KaiyuanGONG/AI-Car/基于人工智能的自动驾驶小车控制——技术报告.md

@[TOC](目录)
# 1.总体思路
## 终极目标
完成小车的控制系统的设计和制作，做到配合小车的算法，实现小车的自动驾驶。

包括：能实现在十字路口根据红绿灯的指示进行自主转弯、	遇到斑马线要减速慢行、	遇到行人要停车让行、	遇到限速牌要调整速度等等
（自动驾驶的验证参考视频以及计算机设计大赛的比赛规则（待上传））

但是因为时间有限，这里只介绍==根据车道线自主移动==这一部分，即小车可以自处在如图所示的场地从起点开始进行自主移动，最后在终点停车。
##  细化目标
要完成自动驾驶小车的控制，最终实现自主移动，需要对要实现的功能进行细化。
#### 人工智能的开发流程
要细化整个过程需要对人工智能的整体开发流程有一个大概的了解，尤其是对于机器学习类的开发流程。（这个部分可以参考计算机设计大赛提供的参考资料（待上传）或者基本操作的《一个人工智能的诞生》（md到时候贴个链接））

总而言之，整个过程分成以下几个部分：

 - ==数据集==，数据集顾名思义就是数据的集合，数据是整个人工智能应用开发的基础，在自动驾驶小车中，数据集包括采集到的车道线、斑马线、限速牌、行人等等。但对小车的车道线检测来说来说，需要车载的处理器连接摄像头进行图像采集。
 *例如，在直行时，小车采集到的图像是两根完整的车道线且分别位于小车视角的左右两侧，但是当需要转弯，即车道线出现弯曲的时候两根车道线会位于小车视角的同一侧或者消失，这时候小车就需要转弯。*
 - ==模型训练==，采集到的数据集将用于人工智能模型训练，这部分是算法同学负责，你只需要知道他在模型训练之后所达到的效果：向模型输入图像，模型会根据图像做出识别，并根据图像输出对应的符号。
 - ==自主移动==，处理器发出符号之后，主控对符号进行接收和分析，并控制小车进行移动（在简单的车道线检测中，只有前几左转右转停车等）。
 
#### 自主移动系统的目标
 根据人工智能在车道线检测自主移动中的流程，小车应该实现两个目标对应两个过程：
 
 - ==图像采集==：小车具有前进后退转弯等基本能力，同时可以控制小车按照带有车道线的路线图进行运动，同时以某个固定频率进行实时的图像采集，并采集到的图像存储在处理器中，并将所采集好的图像按顺序打包发给负责算法的同学。
 - ==自主移动==：小车的主控板在接收到处理器发出的字符之后，必须嫩根据字符进对应移动，比如接收到F小车前进，接收到L小车左转等等。

#### 自主移动系统的设计
在明确目标之后，我们的设计就围绕自主移动系统的目标展开：
（设计总体参考老师提供的计算机设计大赛官方车（硬件资料待上传），省去过多的思考和不必要的麻烦，但同时这样的解决方案明不是最优解）
 - ==系统形态==：小车的动力来源是四个电机带动四个轮子靠摩擦力前进（左前方的轮子定义为0号，顺时针标号依次为1、2、3号），可以通过控制每个轮子的转速和方向来实现小车的直行和转弯。电机固定在一个底盘平台上，除此之外可以在平台上放置处理器、摄像头、电池等等。
 - ==运动模式==：运动模式由四个电机的差速控制。
	在直行时，四个电机都以相同的速度正转。
	转弯时，以左转为例，有两种方式：
	第一种，0、3号轮子反转，1、2号轮子正转，小车会原地转向。
	第二种，0号轮子反转，1、2、3号轮子轮子正转，小车会边前进边转向。
	两种转向的方法其实都一样，改变电机转向的代码也比较容易改。转标准的90度弯用第二种更方便，但是改变角度时会影响速度，时机不好把握；第二种方法把角度和速度完全分开，方便小车根据实时图像进行自动调整。
 - ==电机控制算法==：要完成小车自主移动控制系统，很重要的一点就是小车的运动状态，而小车的运动状态又完全是由四个电机的转动速度和方向决定的，所以对每个电机的转速的控制就非常重要。要做到控制转速能根据目标值快速变化，快速趋于稳定，且能在一定范围内保持稳定
 - ==图像采集过程==：图像采集需要摄像头安装在小车合适的位置，并由处理器控制进行图像采集。在进行图像采集的过程中，小车需要进行远程操控的移动，所以除小车之外需要自己制作一个遥控器用来操控小车进行移动。
 - ==自主移动过程==：小车与处理器之间相互发送信息，需要通过串口通信。

# 2.知识准备
## Arduino
#### Arduino IDE
Arduino中国官网上面有很多大佬写的帖子可以参考一下，我这里分享一个Arduino快速入门全集。
（链接待补充）
#### 一些硬件的基本知识
一般情况下，小车和手柄中电路用模块比较多，知道电压电流的特点、红线接正极黑线接负极这些最基本的电路只是就够用了。
如果想继续精进，比如自己设计电路板等就需要知道整流、放大等常见电路组合的使用和搭建方法。
#### Arduino 与 硬件结合
可以自己购买或者使用实验室的套件，按照我如下的建议路线进行学习：
使用Arduino UNO 点亮板载LED小灯、向串口发送Hello world！、通过串口发送字符来控制小灯的亮灭、点亮外接LED小灯、点亮外接多色小灯、用开关控制小灯、用滑动变阻器控制小灯、用电位器控制小灯、控制一位数码管、控制多位数码管或者点阵、控制LCD屏幕、控制蜂鸣器、控制超声波模块、控制直流电机、控制直流减速电机、配合驱动模块控制直流减速电机。
## Python
学习Python的基本语法。熟悉常见的概念、能看懂基本的代码。控制方面用到的比较少，仅用于借助Python让处理器和主控板之间完成串口通信。
## 其他
#### Github的使用
Github应该都知道就不赘述了，不会用Git托管代码可以多用用GIthub，自己开几个库把代码按照版本放在里面是非常重要的。同时GIthub上面也有非常多大佬的代码，可以扒下来多参考和借鉴，现在好多大公司比如微软都把自己的更新材料放在上面，许多大厂在面试的时候也会问你Github项目，你甚至可以把自己的大作业保存到上面防止丢失，所以作为一个写代码的，有Github账号并熟练使用其功能是非常必要的。（Github首页就有自己的QuickStart，入门非常快）
#### Markdown的使用
Markdown是一种代码式的文本编辑语言，借助这种方式，写文档就和写代码感觉一样，所以这种文本编辑器非常受程序员喜欢，也因此在很多网络资源中，经常会有一个叫readme.md的文件，md这个后缀就说明文件使用Markdown写的，同时也需要用对应的方式打开。我个人非常喜欢用这种语言，以前总是桌面新建一个ｔｘｔ文件来记东西，现在就方便很多了。
至于Markdown的编辑器，我使用的是Ｔｙｐｏｒａ，非常好用，可以在官网直接下载，暂时免费，我这里写了一篇参考文件，可以在下载后打开学习（待上传）
#### SolidWorks的使用
SolidWorks是一个三维建模软件，我在制作小车模型的时候用到了这个非常重要的软件，主要用于对小车的每个零件进行建模为外观设计和加工做准备，小车上的每一个模块每一个零件都进行了详细的建模，这样做出来的小车才会这样严丝合缝。
SolidWorks网上的资源很多，完全可以自己寻找，学习资源建议使用SolidWorks自带的学习资源（位置帮助－基础教程－基础技术），把自带的学习资源学习完你就是高手了，之后就是多动手多画零件，在实践中学习进步会非常快。
## 其他资料
其他资料可以见我的Github库。
# 3.物资准备
主要是写一下做这辆车完整需要用到哪些东西（因为软件也不是很懂，所以主要是写硬件的东西）。绝大部分物资的参数都可以从购买渠道了解到，方便了解到第一手的信息和重新选择购买复现小车。
#### 做硬件的一些设备
就一些基本的，电烙铁得有得会用吧，包括一些配套的烙铁架、焊锡、吸锡器、[导线](https://detail.tmall.com/item.htm?id=41296905861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)、热缩管、热风枪等等。还需要有万用表、示波器等电路功能检测的工具。还有很多肯定会用到的东西我就不多说了，比如剪刀、[镊子](https://detail.tmall.com/item.htm?id=536088476057&spm=a1z09.2.0.0.4d4d2e8dkUuLs9&_u=j35362bc9e25)、热熔胶、３M胶等等。最后就是各种[螺丝](https://item.taobao.com/item.htm?spm=a1z09.2.0.0.4d4d2e8dkUuLs9&id=586305415774&_u=j35362bc02e9)[铜柱](https://detail.tmall.com/item.htm?id=542688036669&spm=a1z09.2.0.0.4d4d2e8dkUuLs9&_u=j35362bc90b2)，建议多用内六角的，然后各种长度都买一些。（做完一个毕设感觉自己宿舍就跟一个小仓库一样）
#### 物品清单及购买渠道汇总
1. 实验室获取：
主控板Arduino Uno以及与其相配套的Aruino豪华配件。（这个不重要，按照我上面写的豪华路线来学习就好了）
2. 淘宝购入
主控板[Arduino Nano](https://item.taobao.com/item.htm?spm=a1z09.2.0.0.4d4d2e8dkUuLs9&id=529472942000&_u=j35362bc22e5)、[Arduino Mega2560](https://item.taobao.com/item.htm?spm=a1z09.2.0.0.4d4d2e8dkUuLs9&id=601910639382&_u=j35362bcc0b4)、Arduino Uno
升压模块、[电源稳压模块](https://detail.tmall.com/item.htm?id=571929153142&spm=a1z09.2.0.0.4d4d2e8dkUuLs9&_u=j35362bc3ea7)、[杜邦线](https://detail.tmall.com/item.htm?id=521388098764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)等等
[１２V定制电池组](https://detail.tmall.com/item.htm?id=520111996213&spm=a1z09.2.0.0.4d4d2e8dkUuLs9&_u=j35362bcaa4b)及其充电器等配件
[３.７V锂电池及其配套电池底座](https://item.taobao.com/item.htm?spm=a1z09.2.0.0.4d4d2e8dkUuLs9&id=15916831250&_u=j35362bcf8fb)等等
[L298N电机驱动模块](https://item.taobao.com/item.htm?spm=a1z09.2.0.0.4d4d2e8dkUuLs9&id=571082650753&_u=j35362bc6a96)
电机及其配套[６５ｍｍ](https://item.taobao.com/item.htm?spm=a1z09.2.0.0.4d4d2e8dkUuLs9&id=584588142034&_u=j35362bca02b)、[８５ｍｍ](https://item.taobao.com/item.htm?spm=a1z09.2.0.0.4d4d2e8dkUuLs9&id=564022532292&_u=j35362bc5fbf)两种轮子、[联轴器JY61](https://detail.tmall.com/item.htm?id=635856208589&spm=a1z09.2.0.0.4d4d2e8dkUuLs9&_u=j35362bc8266)等等
陀螺仪
[碳纤维贴纸](https://detail.tmall.com/item.htm?id=602426608747&spm=a1z09.2.0.0.4d4d2e8dkUuLs9&_u=j35362bc8e05)、[亚克力胶水](https://detail.tmall.com/item.htm?id=593358040993&spm=a1z09.2.0.0.4d4d2e8dkUuLs9&_u=j35362bcab2b)等
3. 闲鱼购入
Jetson Nano裸机、[亚克力外壳](https://detail.tmall.com/item.htm?id=627952530147&spm=a1z09.2.0.0.4d4d2e8dkUuLs9&_u=j35362bc3783)、[无线网卡](https://detail.tmall.com/item.htm?id=634140774131&spm=a1z09.2.0.0.4d4d2e8dkUuLs9&_u=j35362bc0ef7)、[摄像头](https://detail.tmall.com/item.htm?id=636111925349&spm=a1z09.2.0.0.4d4d2e8dkUuLs9&_u=j35362bcd319)等等

#### 学会买东西和加工东西
在整个小车的制作和调试过程中肯定有很多东西是需要购买或者自己加工的，
比如要购买的：电池、各种电源模块、甚至电线，这些东西在买的时候不要贪便宜，一定买值得信赖的店里的。
比如要加工的：亚克力板、打印件。这些东西一般是自己给出图纸，由商家报价，这类东西由于是需要定制的，所以一般价格波动非常大。打印件可以先搜索“速加网”进入官方，然后将零件的图纸上传自动报价，然后把这个价格减去百分之５到百分之１５去淘宝询价。对于亚克力板，直接加这个微信(wxid_8ww2bm30esdu22)加工就完事了，除非你能找到更便宜的或者自己加工，这个是我找了很多加工商之后的优质商家。

# 4.硬件设计
硬件设计分遥控器和小车本体两个部分来说：（因为实物就在手里，所以我就只文字描述，具体图标可以看我论文）（介绍的是小车当前情况的硬件设计，关于改进在最后一部分会说）

（1）遥控器
  - 遥控器的硬件结构比较简单，接线略复杂，但是我会提供手柄模块的电路图（待上传）遥控器一节3.7V的锂电池 经过3.7V转9V的升压模块给 Arduino Nano供电，Arduino Nano直接连接Arduino手柄模块（手柄模块包含遥感和按钮）、蓝牙模块直接连在手柄模块上。

（2）小车本体
 - 小车本体的结构也比较简单，用两节3.7V的电池串联额外给主控板供电。一套电压为12V的锂电池组经过稳压模块给电机驱动模块供电，驱动模块再连接电机的电机电源线和编码器电源线，电机的A B相线连接在主控板上用来接收编码器的脉冲信号来测定电机转动的速度，同时主控给蓝牙模块供电。

# 5.软件设计
这部分采用介绍代码功能加贴代码的形式来描述，代码注释不多，自己理解一下，自认为命名还都挺明白，全部代码可以在我稍后会长传到我的Github上面，可以下载。

（1）遥控器
主要是使用遥控模块的功能，包含一个摇杆和四个按钮，这里只用了摇杆的功能。
摇杆控制逻辑示意图
```c
// Github文件名为Control.ino
/*
板子开关打到3.3V  341/343 365/368 值的范围是0到720  
手柄中间位置的模拟值490/491  523/524，（板子电源选择开关打到5V，值的范围0到1023）
设置一个前进后退转弯的功能
蓝牙模块通信
*/

#include<SoftwareSerial.h>
SoftwareSerial BlueTooth(8, 9); // RX,TX

int Up = 6;    // 上按钮不可用，其他三个正常
int Right = 3; // 按下右边按钮时digitalRead(Right)的值为0，平常默认值为1
int Down = 4;
int Left = 5;
int X, Y = 0;
int style = 0;

void Init()
{
    pinMode(Up, INPUT_PULLUP);
    pinMode(Right, INPUT_PULLUP);
    pinMode(Down, INPUT_PULLUP);
    pinMode(Left, INPUT_PULLUP);
}

// 1，2，3. 4 分别代表前进，右转，后退，左转
void Style()
{

    if (X >= 200 && X <= 500 && Y >= 200 && Y <= 500)
    {
        style = 0;
    }

    if (Y > 500 && X > 200 && X < 500)
    {
        style = 1;
    }

    if (Y > 200 && Y < 500 && X > 500)
    {
        style = 2;
    }

    if (Y < 200 && X > 200 && X < 500)
    {
        style = 3;
    }

    if (Y > 200 && Y < 500 && X < 200)
    {
        style = 4;
    }
}

void setup(void)
{
    Init();
    Serial.begin(9600);
    BlueTooth.begin(9600);
    // Serial.println("init serial port AT");
}

void loop(void)
{
    Style();
    X = analogRead(A0);
    Y = analogRead(A1);

//if(BlueTooth.available()>0) {
    if (digitalRead(Right) == 0){
            BlueTooth.print("U");
        }
    if (digitalRead(Left) == 0){
            BlueTooth.print("C");
    }

    if (style == 0)
    {
        BlueTooth.print("S");
    }
    if (style == 1)
    {
        BlueTooth.print("F");
    }
    if (style == 2)
    {
        BlueTooth.print("R");
    }
    if (style == 3)
    {
        BlueTooth.print("B");
    }
    if (style == 4)
    {
        BlueTooth.print("L");
    }
    delay(1);
}
```

（2）小车本体

小车本体所包含的功能比较多，所以先把几个功能的逻辑讲清楚，然后再贴对应代码。
 - ==小车电机驱动程序设计==
小车使用的是L298N电机驱动模块去驱动六线AB相的直流减速电机。
所以设置一个四行五列的二维数组Motor_Pins来代表四个电机的所有端口，每一行的四个端口分别是IN1、IN2、PWM、EncodeA、EncodeB（即中端A和中断B），（但在实际变成过程中由于Mega2560外部中断接口个数受限，只使用了每个电机的中断A。
当需要驱动电机的时候，先进行端口初始化，IN1、IN2、PWM设置为OUTPUT且默认状态为LOW，中断设置为INPUT。PWM的范围是0-255，通过控制输入PWM值的大小可以决定电机得转速（经过测试，空载速度在0-50，对应的PWM值是40-255）。IN1、IN2根据L298N的真值表，可以决定电机是正转、反转、还是不转。
参考的真值表
 - ==蓝牙模块程序设计==
这个部分主要设计到小车所使用的CH05模块的初始化，参数配置和调试，到时候会贴一个大佬的链接（待上传）
- ==计算电机转速==
因为使用的是带编码器的电机，所以可以通过使用主控的外部中断读取到电机的脉冲频率，再结合电机的加速比等信息可以计算出电机的转速。
Arduino外部中断的使用，使用函数attachInterrupt(interrupt, function, RISING)，上升沿检测信号脉冲，function设置MotorCount变量计数在50ms内的脉冲的个数。
最后速度v = ((MotorCount / (11 * 56)) * 6.5 * PI) / 0.05 其中11表示，电机每转过一圈有11个脉冲，电机减速比是56，轮子的直径是6.5cm，0.05表示在50ms以内。
 - ==PID控制算法==
PID是Proportional(比例)、Integral(积分)、Differential(微分)三者的缩写。PID调节是连续控制系统中技术最成熟、应用最广泛的调节方式。PID调节实质是根据输入的偏差值，按照比例、积分、微分的函数关系进行运算，运算结果用以控制输出。PID有增量式PID和位置式PID两种，由于我们使用的是增量式霍尔编码器所以我们着重研究增量式PID。使用前面提到的增量PID的公式第二条：离散式PID计算公式
在进行代码实现的时候，PWMInc表示PWM的增量，Ek表示目标值与当前值的差，Ek1、Ek2保存上一步的Ek值，Kp、Ki、Kd分别是比例、积分、微分三个系数，计算表达式为PWMInc＝Kp*Ek-Ki*Ｅk1+Kd*EK2。
再加上利用millis()函数的每5ms一次的时间中断。　
然后再每次主程序循环开始之前通过PWM = PWM + PWMInc来不断更新，以改变不同电机的转速。
PID参数的调整，PID三个参数的调整对电机的控制效果有很大的影响且三个参数会相互影响,根据前面章节提到的调参公式和模拟效果，确定最终参数位Kp=5，Ki=0.3.Kd=0.5

```c
// Github文件名为final.ino
/***********************************
电机序号编号
0号电机（LF左前）   1号电机（RF右前）
2号电机（RB右后）   3号电机（LB左后）
*************************************/
/*****************************************
更新日志2021年5月24日，毕业答辩前一天重构代码
******************************************/

// 包含头文件 软串口、定时中断
#include <SoftwareSerial.h>
#include <FlexiTimer2.h>

// 蓝牙接口定义
SoftwareSerial BlueTooth(50, 51); // RX,TX

// 电机端口初始化极其含义
//IN1 IN2 PWM EncodeA EncodeB
int MotorPins[4][5] = {
    {6, 17, 7, 2, 28},
    {12, 15, 4, 21, 30},
    {11, 16, 5, 20, 26},
    {23, 8, 13, 3, 24},
};

// 一些全局变量的定义
// 数圈数 当前速度 目标速度 目标角度 PWM 等
int MotorCount = 0; //反正每次只能测一个电机的转速，所以不是数组
float Velocity[4] = {0};
float Target[4] = {0};
float Target_V = 0; //输入专用速度
String TargetVelocity;
float TargetA = 0;
String TargetAngle;
float PWMControl[4] = {0};
int PWMStart[4] = {0, 0, 0, 0};
int PWM[4] = {0}; //PWM是整数

// PID 参数定义及设置   四个轮子使用四套PID参数
typedef struct
{
    float Kp; //比例系数Proportional
    float Ki; //积分系数Integral
    float Kd; //微分系数Derivative

    float Ek;  //当前误差
    float Ek1; //前一次误差 e(k-1)
    float Ek2; //再前一次误差 e(k-2)
} PID_IncTypeDef;

PID_IncTypeDef pid0 = {10, 1, 0.1, 0, 0, 0};
PID_IncTypeDef pid1 = {10, 1, 0.1, 0, 0, 0};
PID_IncTypeDef pid2 = {10, 1, 0.1, 0, 0, 0};
PID_IncTypeDef pid3 = {10, 1, 0.1, 0, 0, 0};
PID_IncTypeDef pid[4] = {pid0, pid1, pid2, pid3};

// 程序初始化
void setup()
{
    MotorInit();                   //电机初始化
    Serial.begin(9600);            //硬串口初始化
    BlueTooth.begin(9600);         //蓝牙使用的软串口初始化
    FlexiTimer2::set(5, control);  //时间中断初始化
    FlexiTimer2::start();          //每5ms中断一次，中断函数为control
}

// 程序进入主循环
void loop()
{
    // 计算当前实际速度
    GetV();
    // 蓝牙读取遥控器指令及对应操作判断
    char ch = BlueTooth.read(); // 传递信息
    switch (ch)
    {
    case 'S':
        Stop();
        break;

    case 'F':
        GoForward(1);
        break;

    case 'B':
        GoBackward(1);
        break;
    case 'L':

        TurnLeft(60);
        break;
    case 'R':

        TurnRight(60);
        break;
        
// 对电机的各个参数进行初始化
void MotorInit()
{
    for (int i = 0; i < 4; i++)
    {
        pinMode(MotorPins[i][0], OUTPUT);
        pinMode(MotorPins[i][1], OUTPUT);
        pinMode(MotorPins[i][2], OUTPUT);
        pinMode(MotorPins[i][3], INPUT);
        pinMode(MotorPins[i][4], INPUT);

        digitalWrite(MotorPins[i][0], LOW);
        digitalWrite(MotorPins[i][1], LOW);
        digitalWrite(MotorPins[i][2], LOW);
    }
}

// 定时中断的函数
void control()
{
    //计算对应当前目标速度的PWM增量值
    for (int n = 0; n < 4; n++)
    {
        PWMControl[n] = PwmInc(n, Target[n]);
    }
    // 对PWMControl的值进行处理并得到PWM
    SetPWM();
    // 不断更新角度数据
}

//计算当前某序号电机的实际速度
void GetV()
{
    // n是电机的序号,更新并保存四个电机的转速
    for (int n = 0; n < 4; n++)
    {
        MotorCount = 0;
        unsigned long nowtime = 0;
        nowtime = millis() + 50;
        attachInterrupt(digitalPinToInterrupt(MotorPins[n][3]), ReadMotor, RISING); // 2560 的中断2口对应编号0
        while (millis() < nowtime)
            ;
        detachInterrupt(digitalPinToInterrupt(MotorPins[n][3]));
        // 轮组直径8.5cm 电机A相每圈11个脉冲 电机减速比为56：1 计算转速时间间隔为50ms
        Velocity[n] = MotorCount * 8.5 * PI / 11 / 56 / 0.05;
    }
}
void ReadMotor()
{
    MotorCount++;
}

// 不同的运动模式
void DriveMotor(int n, int TargetV)
{
    Target[n] = TargetV;
    if(Target[n] == 0) {
        digitalWrite(MotorPins[n][0], LOW);
        digitalWrite(MotorPins[n][1], LOW);
    }
    if(Target[n] > 0) {
        digitalWrite(MotorPins[n][0], LOW);
        digitalWrite(MotorPins[n][1], HIGH);
    }
    if(Target[n] < 0) {
        digitalWrite(MotorPins[n][0], HIGH);
        digitalWrite(MotorPins[n][1], LOW);
    }
    analogWrite(MotorPins[n][2], PWMStart[n]+PWM[n]);
}

void Stop()
{
    // 为了保证响应速度，每个电机会设置一个刚好不使轮子转动的PWM值
    Target[0] = 0;
    Target[1] = 0;
    Target[2] = 0;
    Target[3] = 0;
}
void GoForward(int TargetV)
{
    Target[0] = TargetV;
    Target[1] = TargetV;
    Target[2] = TargetV;
    Target[3] = TargetV;
}
void GoBackward(int TargetV)
{
    Target[0] = -TargetV;
    Target[1] = -TargetV;
    Target[2] = -TargetV;
    Target[3] = -TargetV;
}
void TurnLeft(int TargetV)
{
    Target[0] = -TargetV;
    Target[1] = TargetV;
    Target[2] = TargetV;
    Target[3] = TargetV;
}
void TurnRight(int TargetV)
{
    Target[0] = TargetV;
    Target[1] = -TargetV;
    Target[2] = TargetV;
    Target[3] = TargetV;
}

//输出电机的转速、PWM值、角度
void PrintV()
{
    Serial.println("******输出电机转速******");
    for (int i = 0; i < 4; i++)
    {
        Serial.print("Motor");
        Serial.print(i);
        Serial.print(":");
        Serial.print(Velocity[i]);
        Serial.print("  ");
    }
    Serial.println();
}
void PrintPwm()
{
    Serial.println("******输出电机PWM值******");
    for (int i = 0; i < 4; i++)
    {
        Serial.print("PWM");
        Serial.print(i);
        Serial.print(":");
        Serial.print(PWM[i]);
        Serial.print("  ");
    }
    Serial.println();
}
void PrintAngle()
{
}

// 将计算好的PWMControl进行限制并赋值到PWM[4]
void SetPWM()
{
    for (int n = 0; n < 4; n++)
    {
        if (PWMControl[n] > 255)
        {
            PWM[n] = 255;
        }
        PWM[n] = (int)PWMControl;
    }
    DriveMotor(0, Target[0]);
    DriveMotor(1, Target[1]);
    DriveMotor(2, Target[2]);
    DriveMotor(3, Target[3]);
}

// 通过增量PID计算PWM增量
float PwmInc(int n, float SetValue)
{
    if(SetValue < 0) {
        SetValue = -SetValue;
    }
    float PWMInc = 0;
    float ActualValue = 0;

    PID_IncTypeDef *PID = &pid[n];

    ActualValue = Velocity[n];

    PID->Ek = SetValue - ActualValue;
    PWMInc += (PID->Kp * PID->Ek) - (PID->Ki * PID->Ek1) + (PID->Kd * PID->Ek2);

    PID->Ek2 = PID->Ek1;
    PID->Ek1 = PID->Ek;

    return PWMInc;
}

```

# 6.测试及问题
## 已解决的问题
#### PID使用的问题
#### 遥控器与小车通信的问题

## 仍存在的问题
#### 结构方面
- 四个轮子中心所构成的不是一个正方形，这个问题还是比较致命的，会导致小车在转弯的时候动力不够。之前设计的时候是由考虑好的，但是由于换了85mm轮子没有考虑轮子宽度，所以调换了安装方向。
- 开关位置不合适，开关就是塞到底盘板里面的，但是由于尺寸设计问题，开关会必预设的低很多，有时候会导致非常尴尬的意外关机的情况，这个问题很好解决，把开关塞进去就行了。
- 供电问题，理想状态下应该是小车的电池给处理器供电，处理器的USB接口再给主控板供电，但是现在主控板外接两3.7V电池串联供电，处理器用充电宝供电，然后用远程桌面控制。之后应该改成同一由12V电池给所有用电设备供电（包括更多的用电设备例如显示屏和摄像头等），这也是一开始就选择定制大容量锂电池的初心。
- 外壳设计方面，本来在设计之初，应该是每个板的厚度都是5mm然后都用3mm的螺丝固定，但是再加工的时候脑抽了，觉得3mm便宜所以部分选了3mm的，最后导致没有找到合适的螺母最终无法完成装配，最后用亚克力胶粘的，这个真的是设计的一大败笔，后边要继续用的话肯定得改进重做。
#### 功能方面
- 陀螺仪没加，开始的时候看了官方小车的操作流程。感觉需要角度角度和速度的实时反馈，但是实际队友在操作的时候明显使用了一种非常简单的方式，所以就只加了陀螺仪，但是代码没有加进去。
- 角度PID，加入陀螺仪之后，角度控制也需要配置PID，这样才能实现角度的控制。
- 遥控器，之前我在使用遥控器的时候是没有问题的，但是在遥控器放了很久，新车刚装好的时候，遥控器出了问题，我认为是遥控器的手柄模块摇杆部分出现了问题或者是蓝牙部分的供电电路存在问题，导致小车在用遥控器控制的时候。

# 7.总结与展望
从一开始选了郑老师这个题目撰写任务书、开题报告，再到最后毕业答辩结束。在做毕设中遇到了很多困难，也一一化解，并从中学到了很多。

现在回想起来，其实导致很多困难以及最终结果不遂人愿的原因是很大一个原因是：只知道最终目标和完成的效果，但是对细节目标及其不明确，不知道是在做什么、不知道方案执行中的细节，说人话就是从一开始到最后写完论文都是在瞎做。

但是现在回过头来写技术报告，是非常清晰和明了，这也就是我问什么在这篇技术报告的第一章就写细化目标的原因，这部分才本次毕业设计工程问题真正的精髓，如果这部分很清楚，后边的技术部分也是如鱼得水顺理成章。

这大概也就是做工程设计解决工程问题的魅力吧，只有一个前进的方向和目标，但是道路黑灯瞎火甚至还崎岖不平，最终克服重重困难到达胜利的彼岸。
