KaiyuanGONG/AI-Car/官方资料/地图/地图测试.pptx

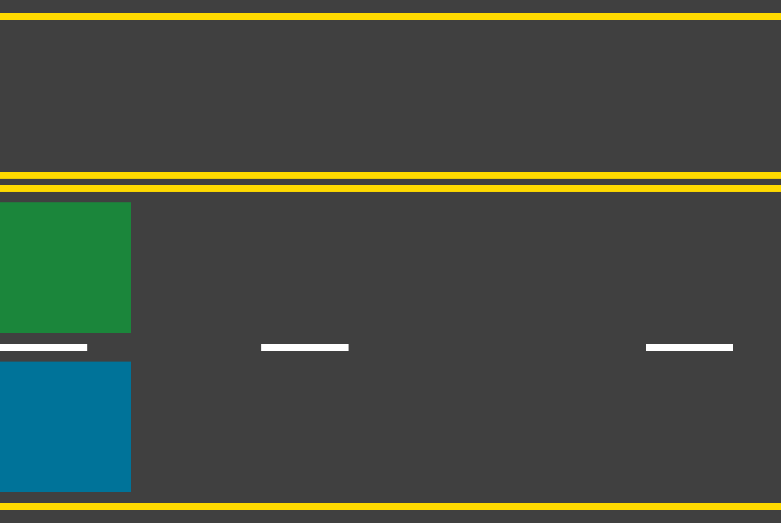
[picture p17: figure]
左侧直车道
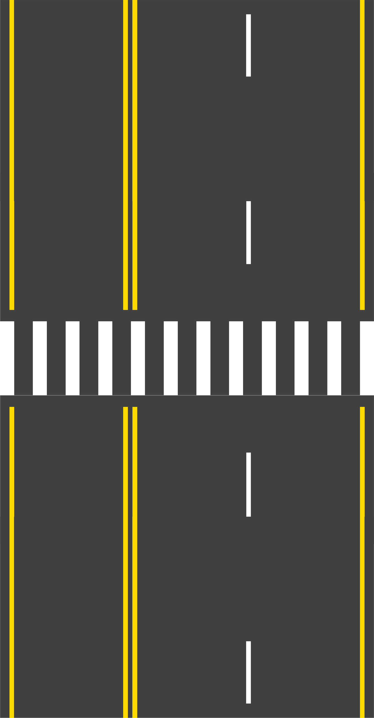
[picture p18: figure]
最终斑马线
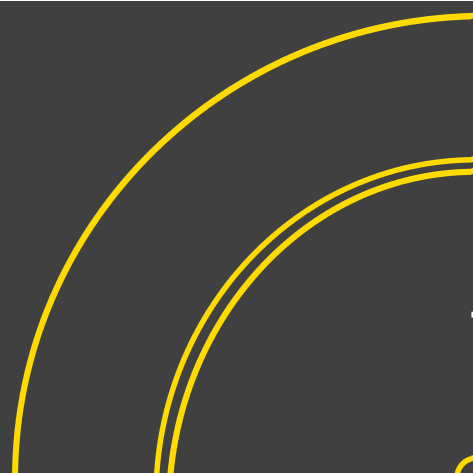
[picture p19: figure]
07 右转弯
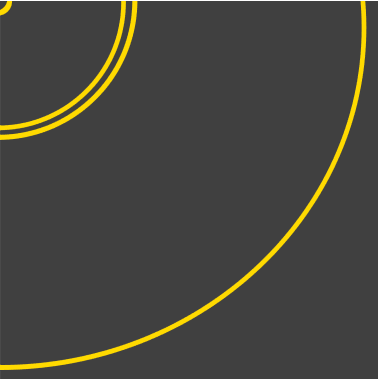
[picture p20: figure]
03 左转弯
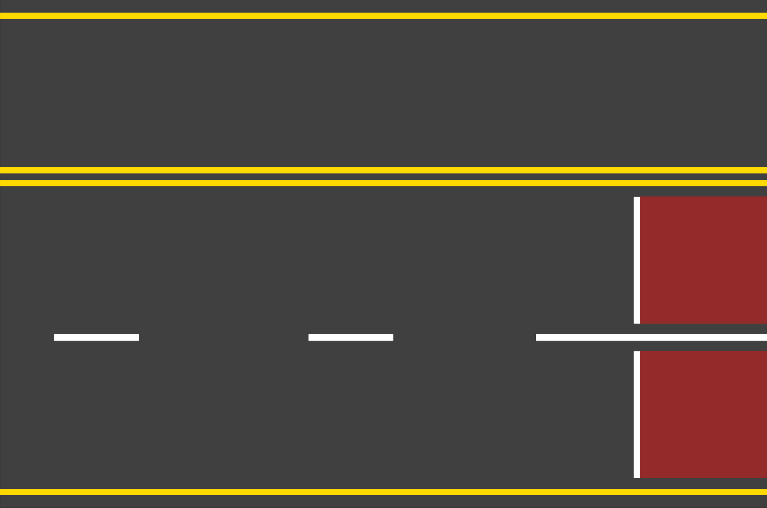
[picture p21: figure]
右侧直车道
