KaiyuanGONG/AI-Car/其他资料/JoyShield资料/PINOUT==0G-00004701==JoystickShield.jpg

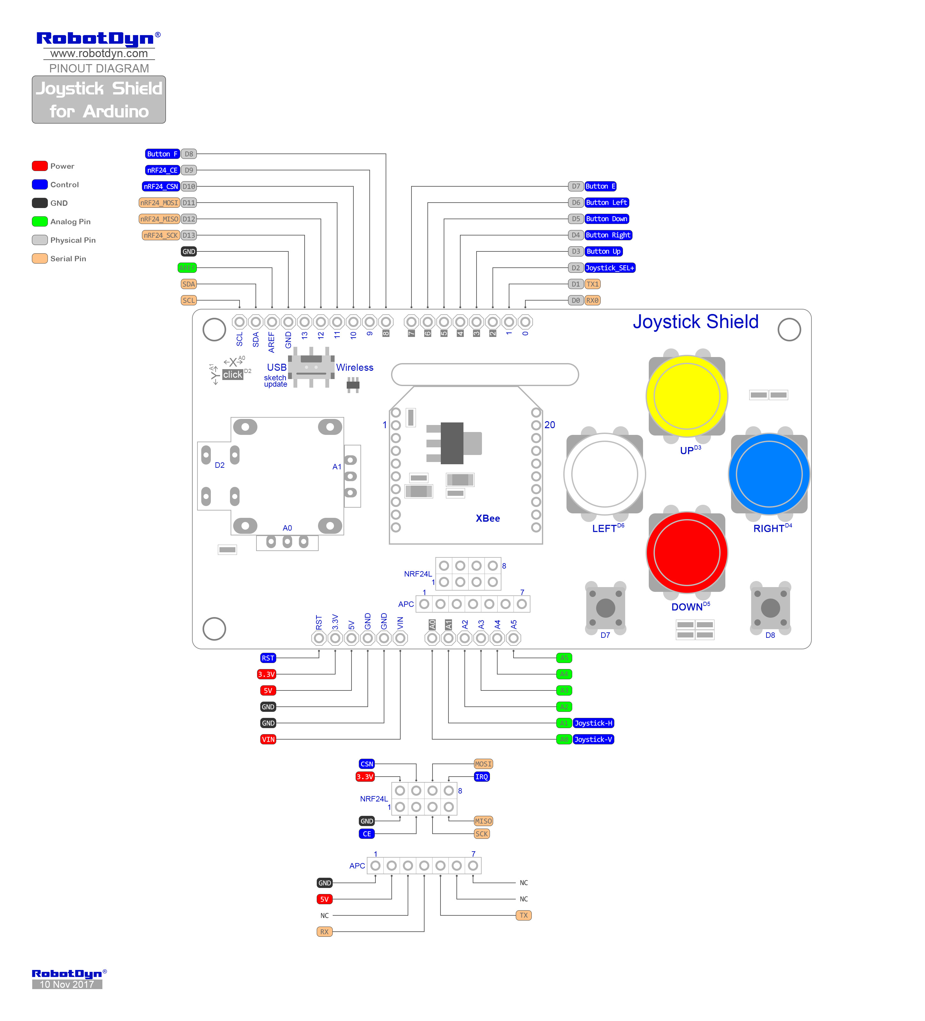
其他资料/JoyShield资料/PINOUT==0G-00004701==JoystickShield.jpg
