KaiyuanGONG/AI-Car/官方资料/地图/R01.png

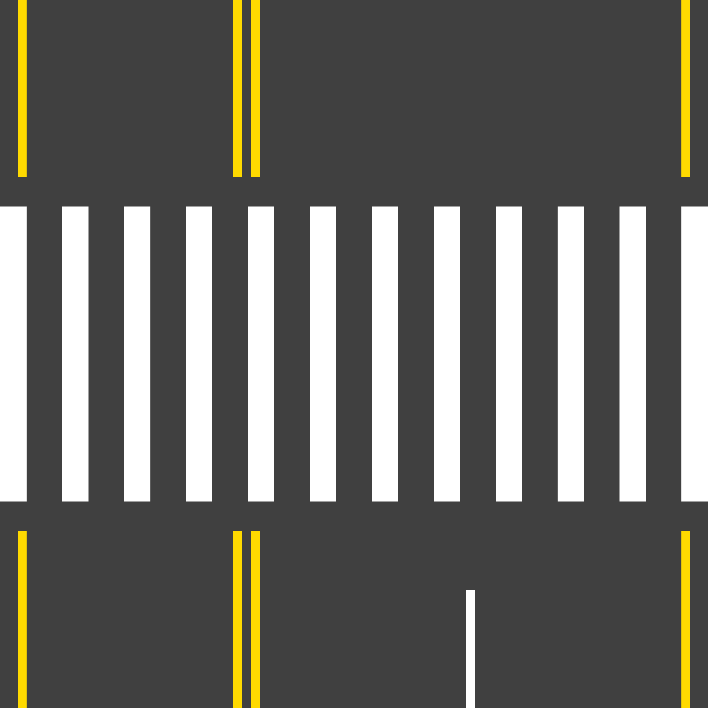
官方资料/地图/R01.png
