KaiyuanGONG/AI-Car/手柄模型/手柄装配体/手柄装配体.SLDASM

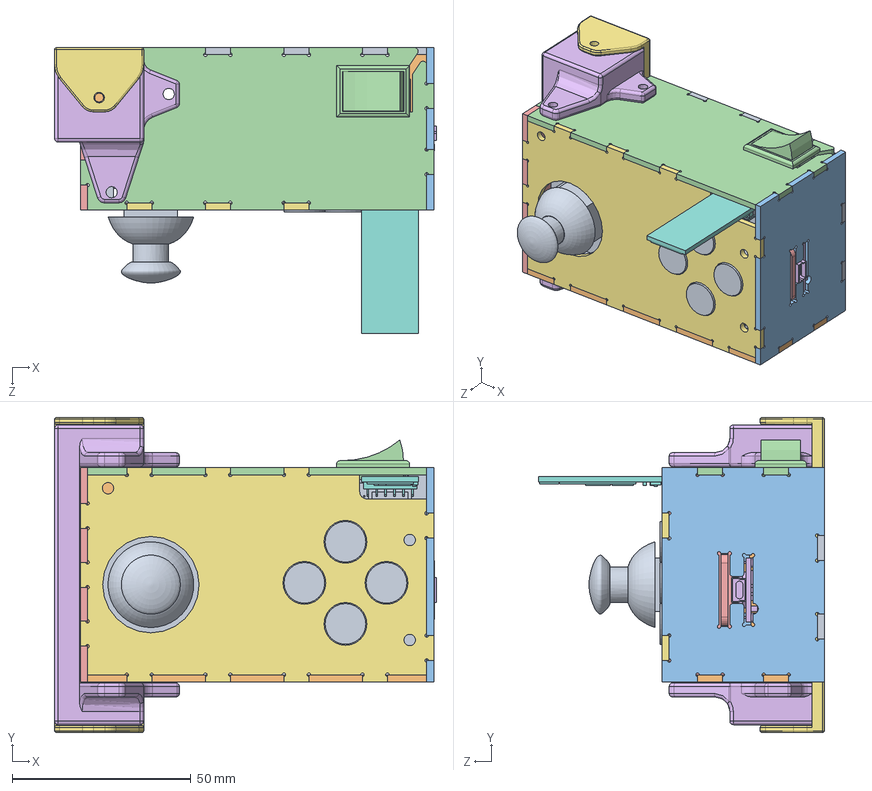
[picture p30: CAD file, 2021-06-19]
手柄模型/手柄装配体/手柄装配体.SLDASM
107.0 x 88.3 x 80.1 mm
JoyShield
BaseBattery
3.7V9
SwitchTwoFt
Board_Nano
Nano
Board_Joy
HC05BlousTooth
Board_Bottom
Board_Side2
Board_Side1
Board_Side0
Board_Side3
Protect_Bat
Board_Bat
