KaiyuanGONG/AI-Car/机械图纸/装配体/车壳（除底盘）.SLDASM

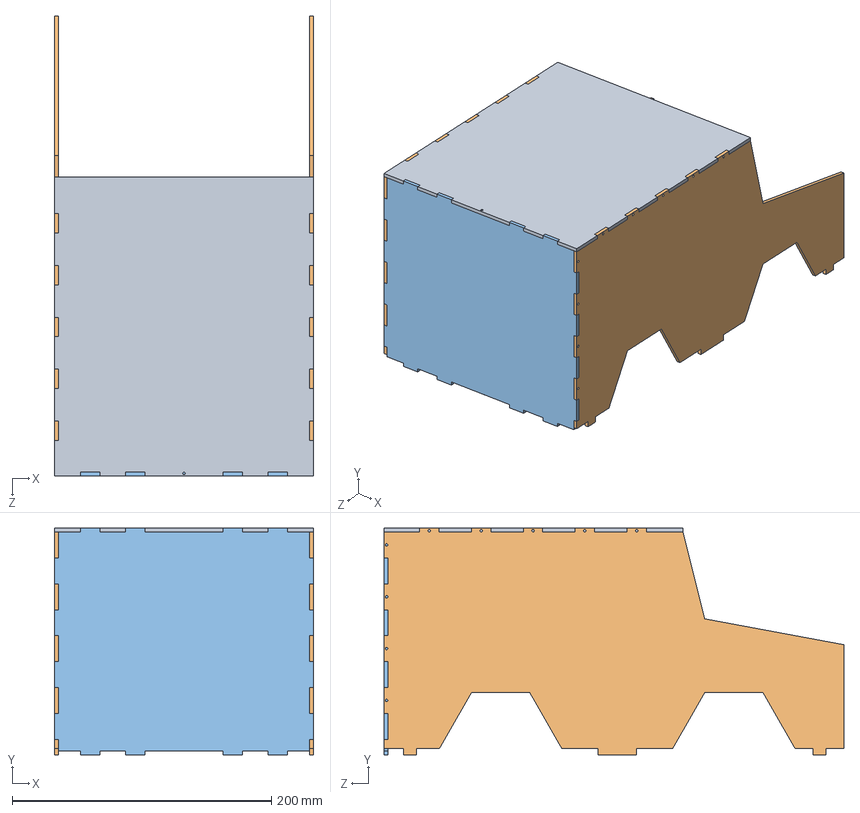
[picture p31: CAD file, 2021-06-19]
机械图纸/装配体/车壳（除底盘）.SLDASM
200.0 x 175.0 x 355.0 mm
车顶板
车侧板 x 2
车后板
