KaiyuanGONG/AI-Car/机械图纸/轮组/低轮组.SLDASM

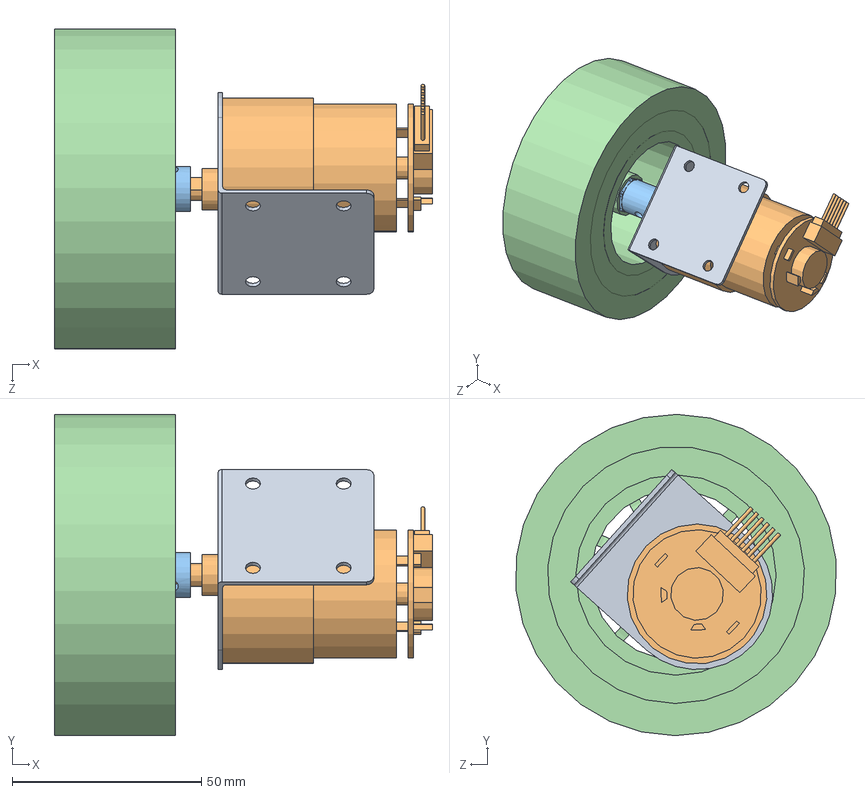
[picture p32: CAD file, 2021-06-19]
机械图纸/轮组/低轮组.SLDASM
100.0 x 85.0 x 84.6 mm
BaseMotor
Motor
Coupling
Tyre
