KaiyuanGONG/AI-Car/机械图纸/装配体/计算核心.SLDASM

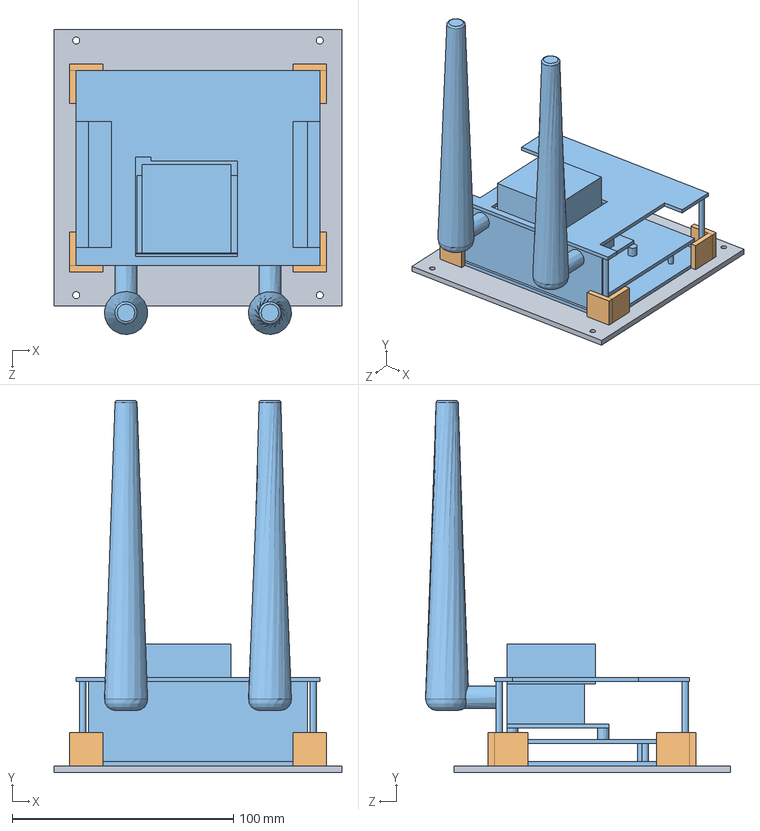
[picture p33: CAD file, 2021-06-19]
机械图纸/装配体/计算核心.SLDASM
130.0 x 168.0 x 137.8 mm
Nano固定
电池挡板 x 8
JatsonNano
