KaiyuanGONG/AI-Car/机械图纸/装配体/电源供电.SLDASM

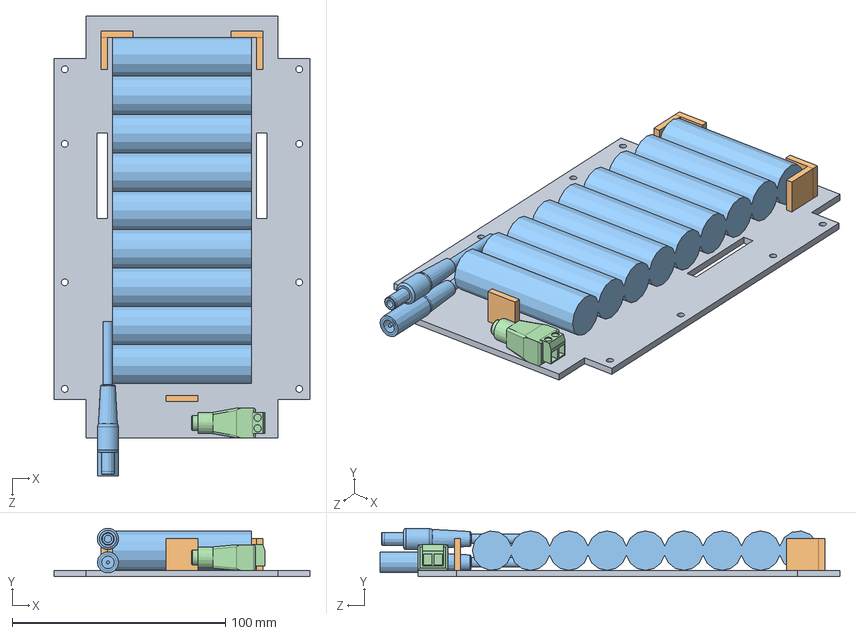
[picture p34: CAD file, 2021-06-19]
机械图纸/装配体/电源供电.SLDASM
120.0 x 22.8 x 215.9 mm
电池固定板
电池挡板 x 5
Battery
ConnectorFemale
