KaiyuanGONG/AI-Car/机械图纸/装配体/整车外壳.SLDASM

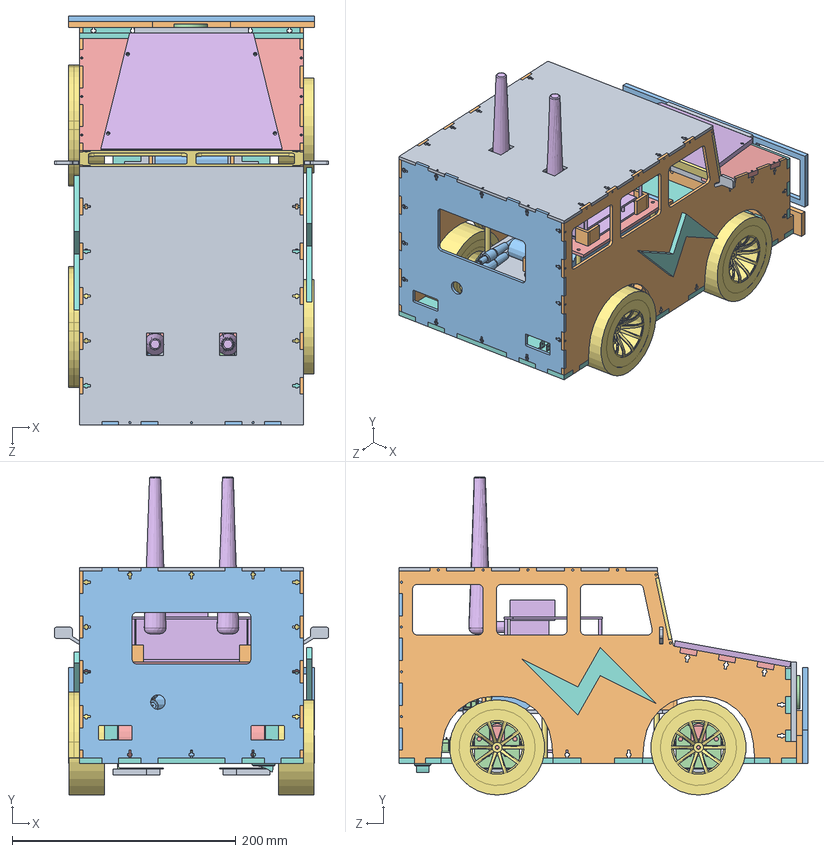
[picture p35: CAD file, 2021-06-19]
机械图纸/装配体/整车外壳.SLDASM
244.9 x 284.0 x 365.0 mm
车顶板
车侧板 x 2
车后板
BaseMotor x 4
Motor x 4
Coupling x 4
Tyre x 4
底盘
轮组固定板 x 4
L298N x 2
JY61
VoltageRegulatorSourse
分电板
40mm支撑铜柱 x 8
SwitchTwoFt
电池固定板
电池挡板 x 13
Battery
ConnectorFemale
Nano固定
JatsonNano
前挡风玻璃
车大灯 x 2
车前网
前保险杠
车前架
奔驰标志
引擎盖翼 x 2
引擎盖中
轮胎装饰 x 4
侧边装饰 x 2
后视镜 x 2
