KaiyuanGONG/AI-Car/机械图纸/装配体/底盘装配体.SLDASM

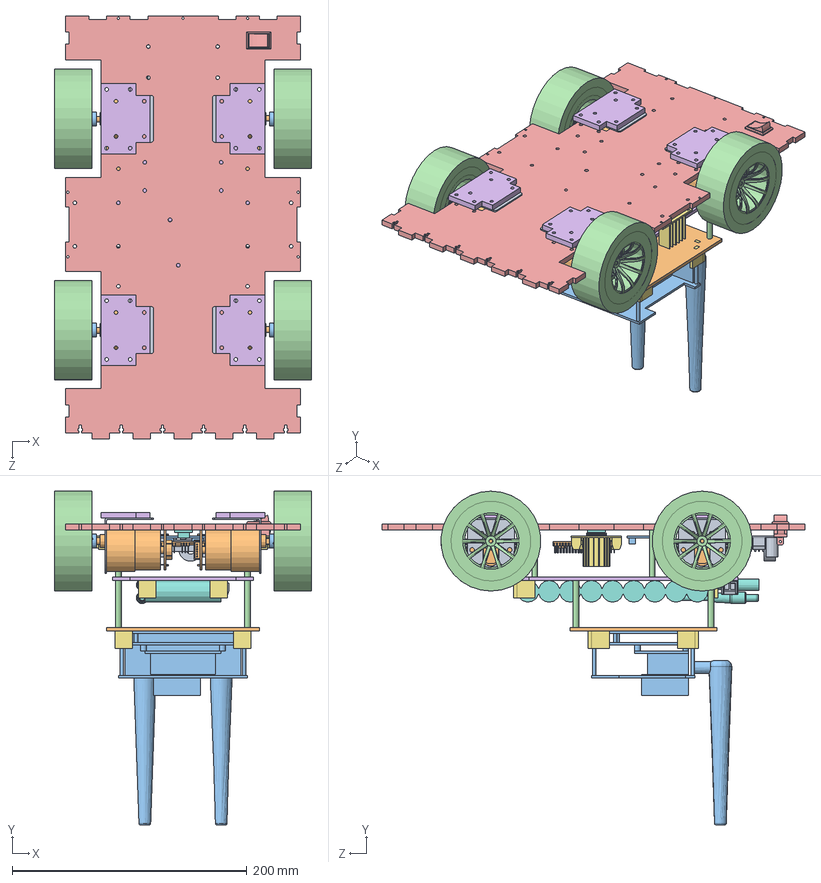
[picture p36: CAD file, 2021-06-19]
机械图纸/装配体/底盘装配体.SLDASM
219.0 x 284.0 x 360.0 mm
BaseMotor x 4
Motor x 4
Coupling x 4
Tyre x 4
底盘
轮组固定板 x 4
L298N x 2
JY61
VoltageRegulatorSourse
分电板
40mm支撑铜柱 x 8
SwitchTwoFt
电池固定板
电池挡板 x 13
Battery
ConnectorFemale
Nano固定
JatsonNano
