KaiyuanGONG/AI-Car/手柄模型/手柄机械零件/Board_Side1.SLDPRT

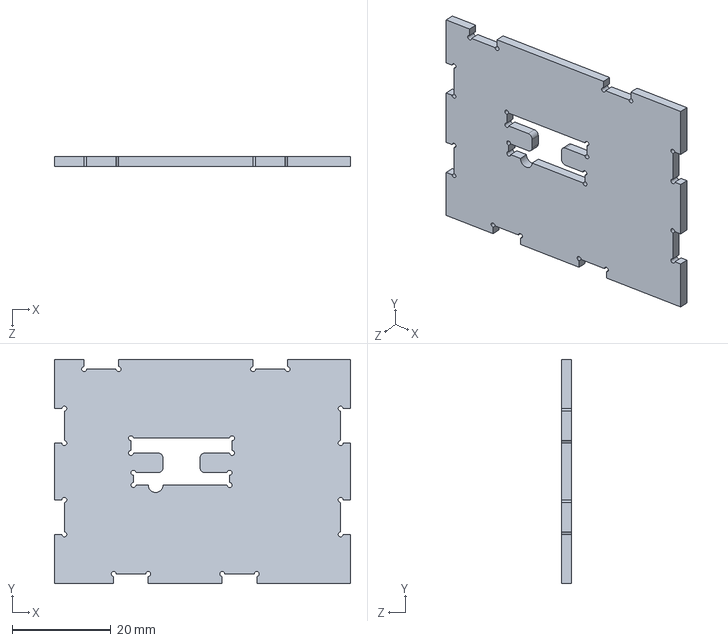
[picture p37: CAD file, 2021-06-19]
手柄模型/手柄机械零件/Board_Side1.SLDPRT
60.0 x 45.5 x 2.00 mm
