KaiyuanGONG/AI-Car/手柄模型/手柄电气零件/JoyShield.SLDPRT

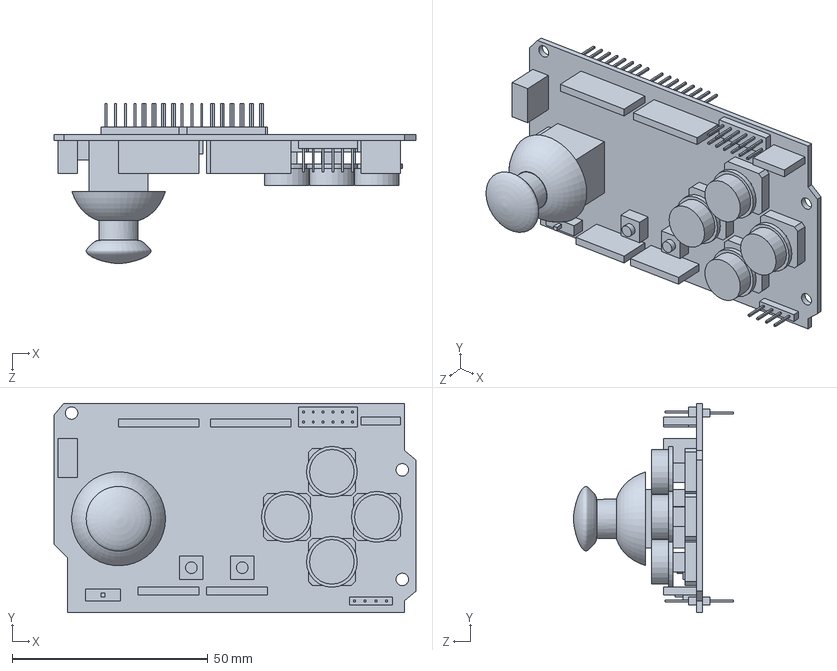
[picture p38: CAD file, 2021-06-19]
手柄模型/手柄电气零件/JoyShield.SLDPRT
92.5 x 53.5 x 41.0 mm
