KaiyuanGONG/AI-Car/机械图纸/外壳零件/车大灯.SLDPRT

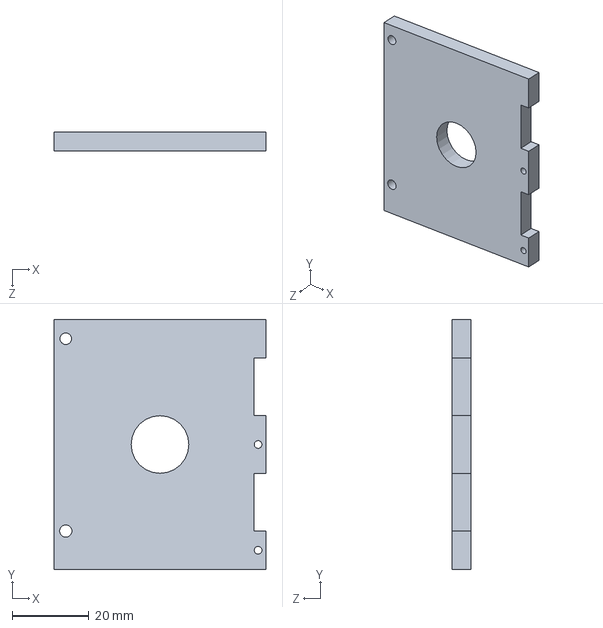
[picture p39: CAD file, 2021-06-19]
机械图纸/外壳零件/车大灯.SLDPRT
55.0 x 65.0 x 5.00 mm
