KaiyuanGONG/AI-Car/机械图纸/底盘（待使用）.SLDPRT

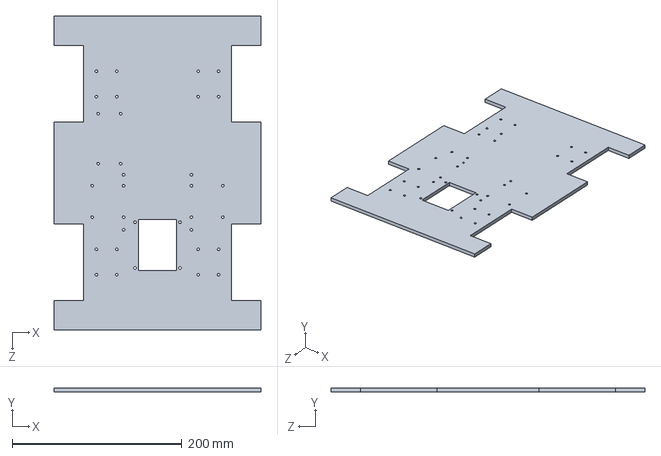
[picture p40: CAD file, 2021-06-19]
机械图纸/底盘（待使用）.SLDPRT
244.0 x 5.00 x 370.0 mm
