KaiyuanGONG/AI-Car/机械图纸/电气零件/JY61.SLDPRT

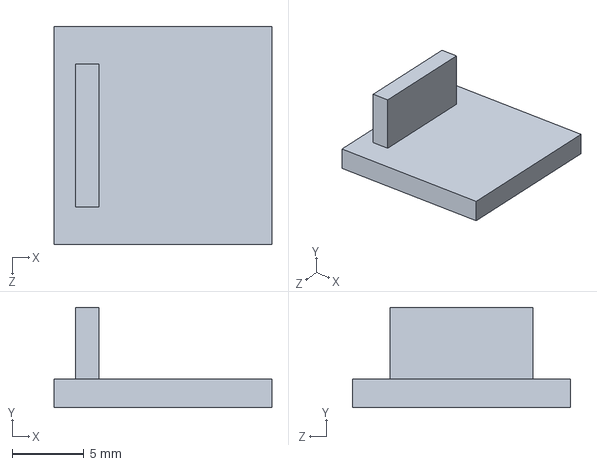
[picture p41: CAD file, 2021-06-19]
机械图纸/电气零件/JY61.SLDPRT
15.2 x 7.00 x 15.2 mm
