KaiyuanGONG/AI-Car/手柄模型/手柄机械零件/Board_Bottom.SLDPRT

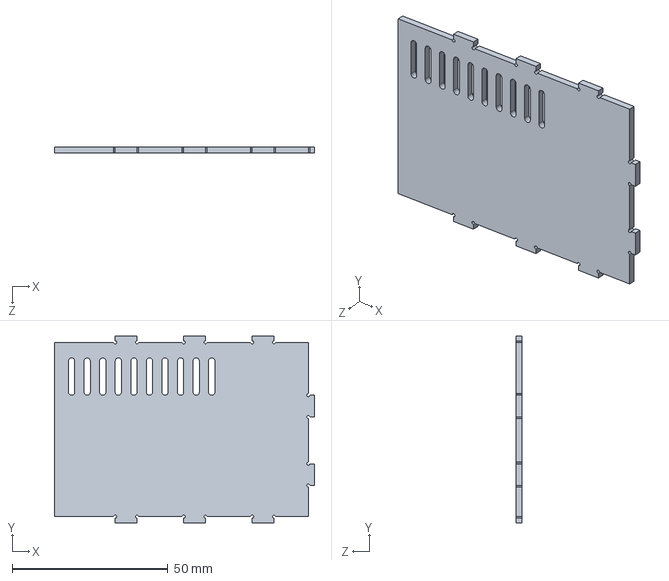
[picture p42: CAD file, 2021-06-19]
手柄模型/手柄机械零件/Board_Bottom.SLDPRT
83.5 x 60.0 x 2.00 mm
