KaiyuanGONG/AI-Car/手柄模型/手柄电气零件/BaseBattery.SLDPRT

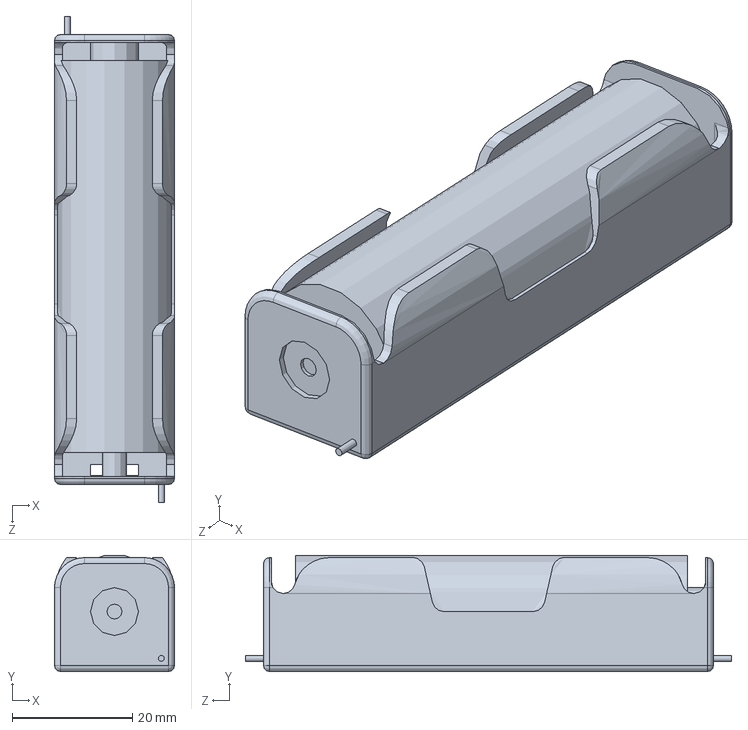
[picture p43: CAD file, 2021-06-19]
手柄模型/手柄电气零件/BaseBattery.SLDPRT
20.0 x 19.4 x 81.0 mm
