KaiyuanGONG/AI-Car/机械图纸/外壳零件/轮胎装饰.SLDPRT

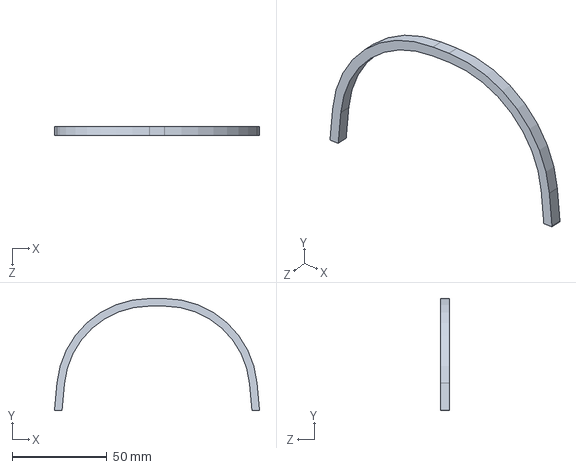
[picture p44: CAD file, 2021-06-19]
机械图纸/外壳零件/轮胎装饰.SLDPRT
108.0 x 59.0 x 5.00 mm
