KaiyuanGONG/AI-Car/机械图纸/电气零件/ConnectorFemale.SLDPRT

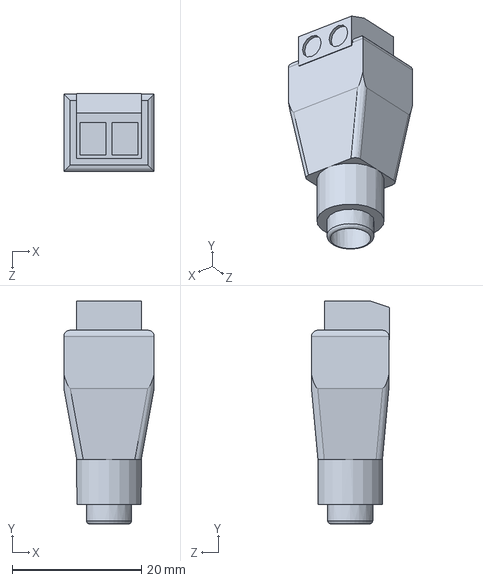
[picture p45: CAD file, 2021-06-19]
机械图纸/电气零件/ConnectorFemale.SLDPRT
14.0 x 34.5 x 12.1 mm
