KaiyuanGONG/AI-Car/机械图纸/轮组/Motor.SLDPRT

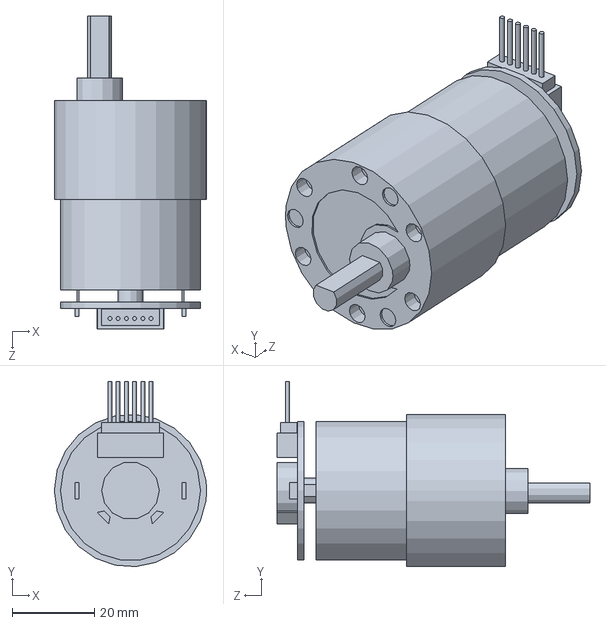
[picture p46: CAD file, 2021-06-19]
机械图纸/轮组/Motor.SLDPRT
37.0 x 45.0 x 76.0 mm
