KaiyuanGONG/AI-Car/手柄模型/手柄机械零件/Board_Side3.SLDPRT

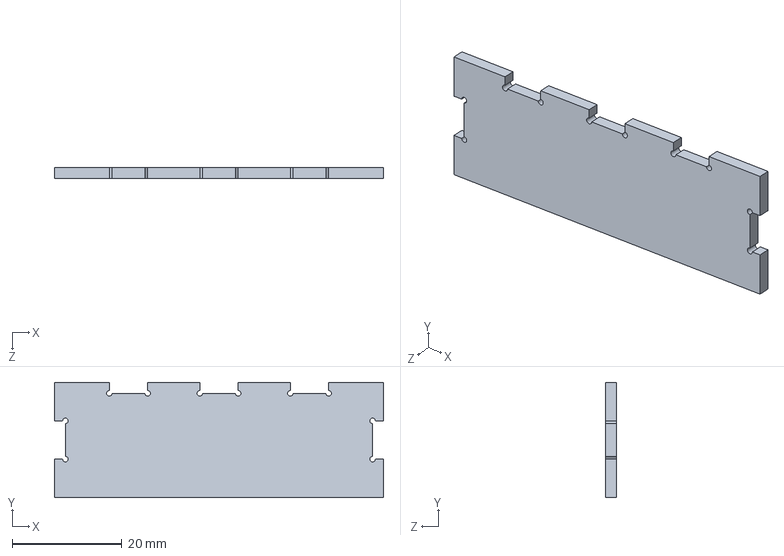
[picture p47: CAD file, 2021-06-19]
手柄模型/手柄机械零件/Board_Side3.SLDPRT
60.0 x 21.0 x 2.00 mm
