KaiyuanGONG/AI-Car/手柄模型/手柄电气零件/3.7V9.SLDPRT

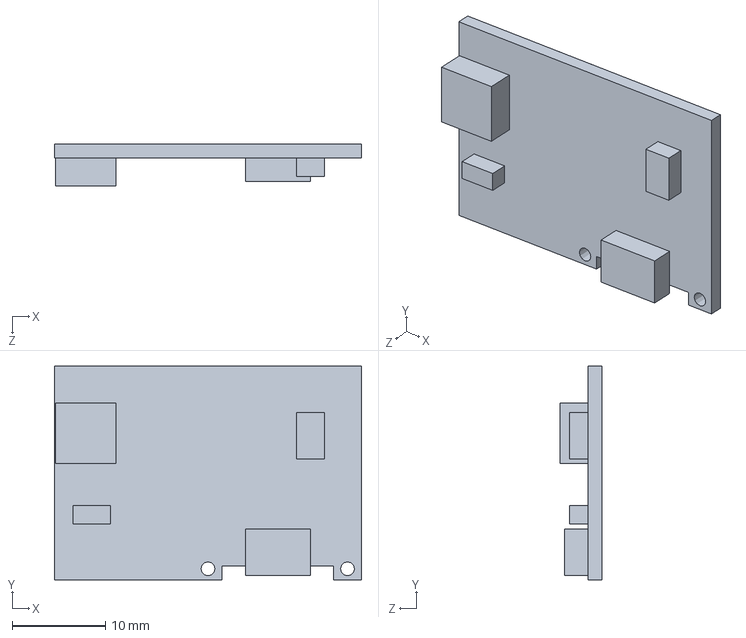
[picture p48: CAD file, 2021-06-19]
手柄模型/手柄电气零件/3.7V9.SLDPRT
33.0 x 23.0 x 4.50 mm
