KaiyuanGONG/AI-Car/机械图纸/外壳零件/底盘.SLDPRT

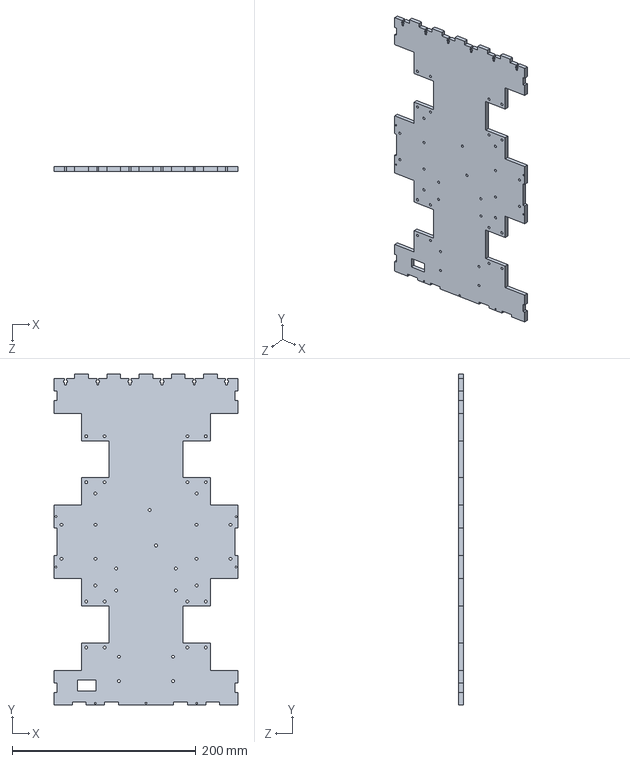
[picture p49: CAD file, 2021-06-19]
机械图纸/外壳零件/底盘.SLDPRT
200.0 x 360.0 x 5.00 mm
