KaiyuanGONG/AI-Car/机械图纸/电气零件/L298N.SLDPRT

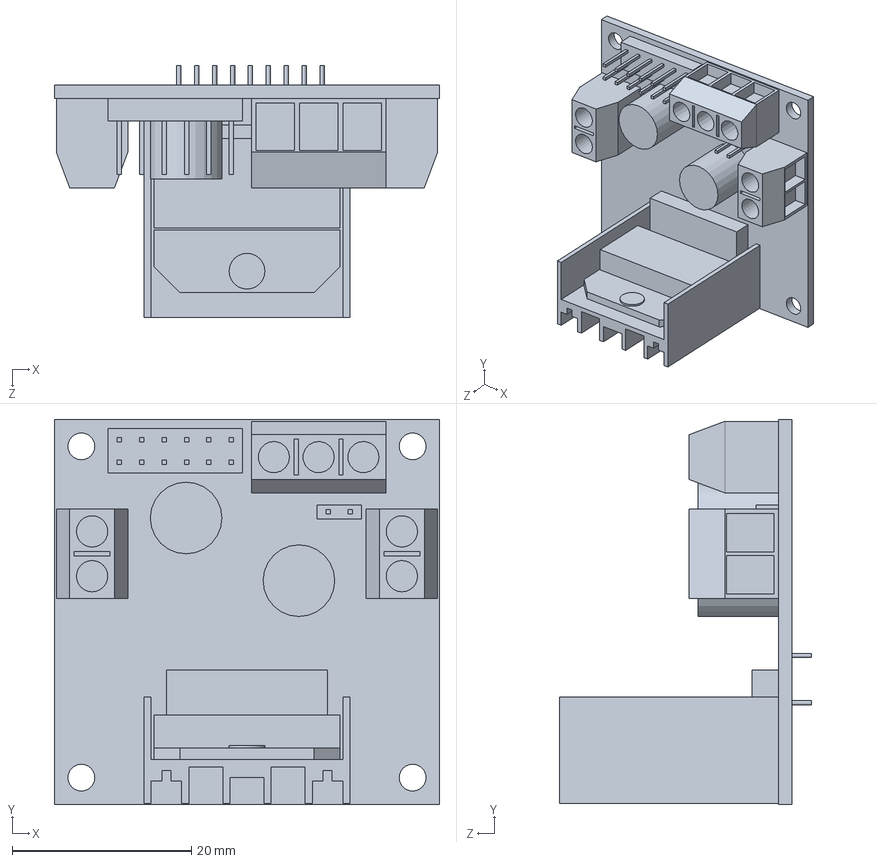
[picture p50: CAD file, 2021-06-19]
机械图纸/电气零件/L298N.SLDPRT
43.0 x 43.0 x 28.2 mm
