KaiyuanGONG/AI-Car/手柄模型/手柄机械零件/Board_Bat.SLDPRT

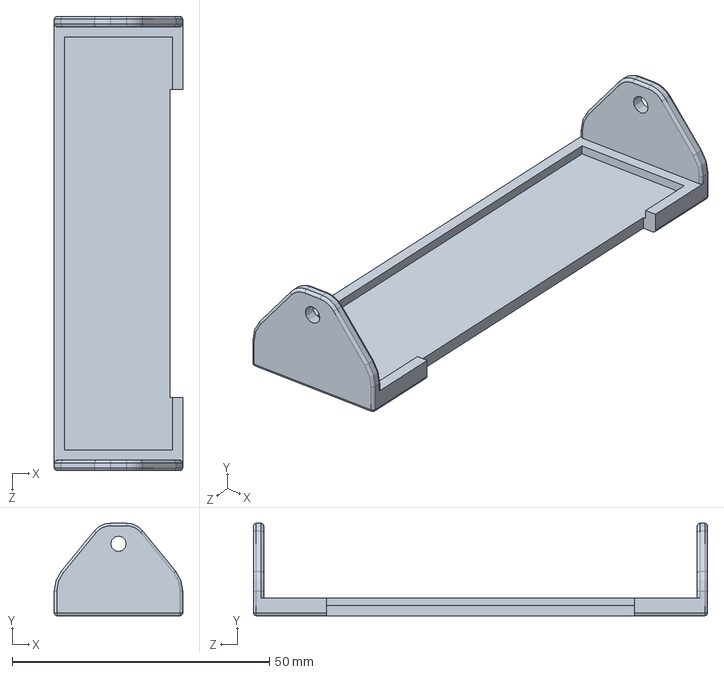
[picture p51: CAD file, 2021-06-19]
手柄模型/手柄机械零件/Board_Bat.SLDPRT
25.0 x 18.0 x 88.3 mm
