KaiyuanGONG/AI-Car/手柄模型/手柄电气零件/Nano.SLDPRT

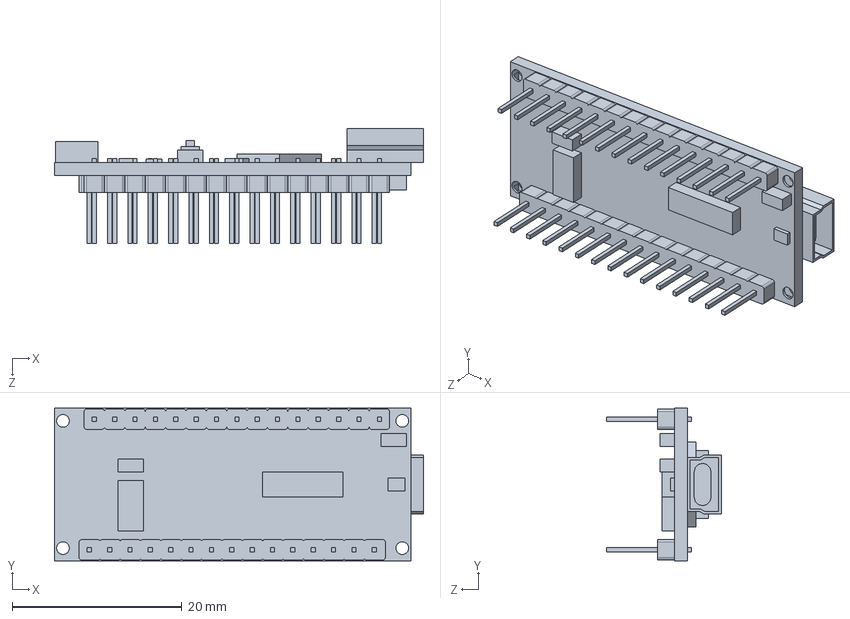
[picture p52: CAD file, 2021-06-19]
手柄模型/手柄电气零件/Nano.SLDPRT
43.5 x 18.0 x 13.5 mm
