KaiyuanGONG/AI-Car/机械图纸/外壳零件/轮组固定板.SLDPRT

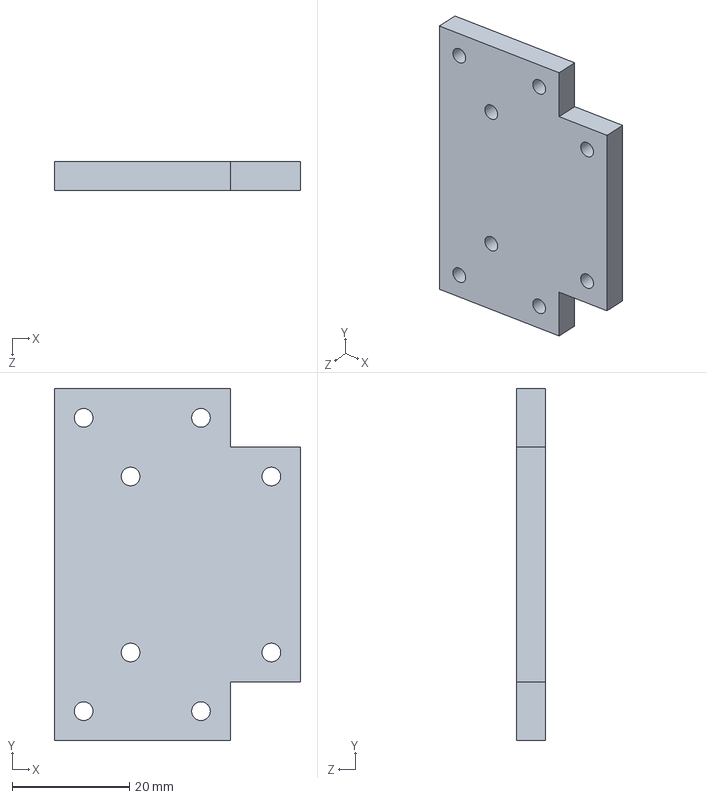
[picture p53: CAD file, 2021-06-19]
机械图纸/外壳零件/轮组固定板.SLDPRT
42.0 x 60.0 x 5.00 mm
