KaiyuanGONG/AI-Car/机械图纸/电气零件/分电板.SLDPRT

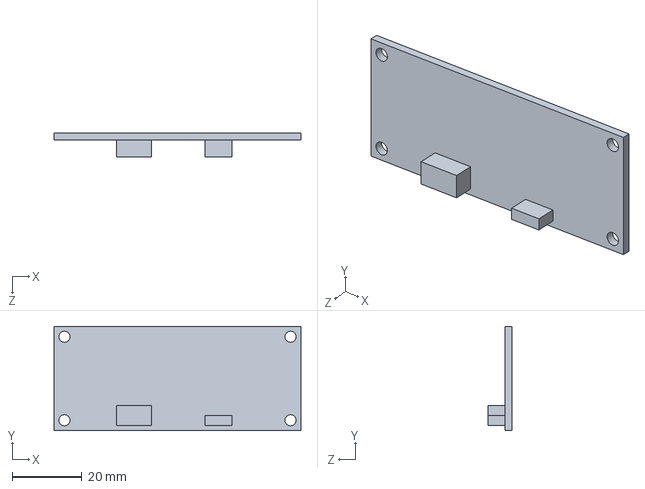
[picture p54: CAD file, 2021-06-19]
机械图纸/电气零件/分电板.SLDPRT
71.0 x 30.0 x 7.00 mm
