KaiyuanGONG/AI-Car/机械图纸/轮组/Tyre.SLDPRT

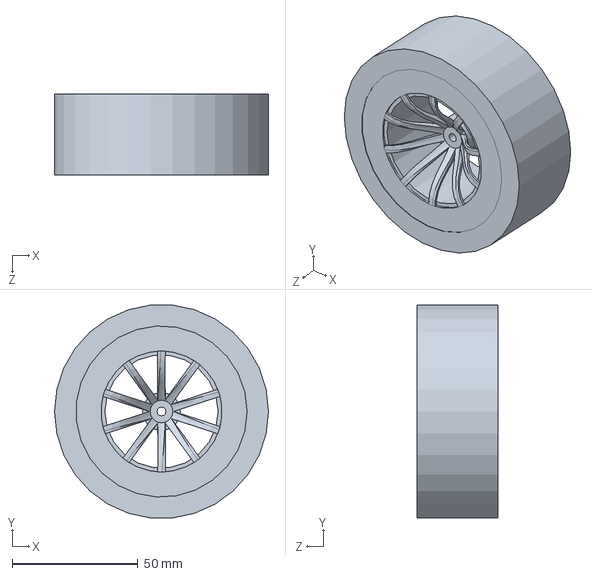
[picture p55: CAD file, 2021-06-19]
机械图纸/轮组/Tyre.SLDPRT
85.0 x 84.5 x 32.0 mm
