KaiyuanGONG/AI-Car/手柄模型/手柄机械零件/角码.SLDPRT

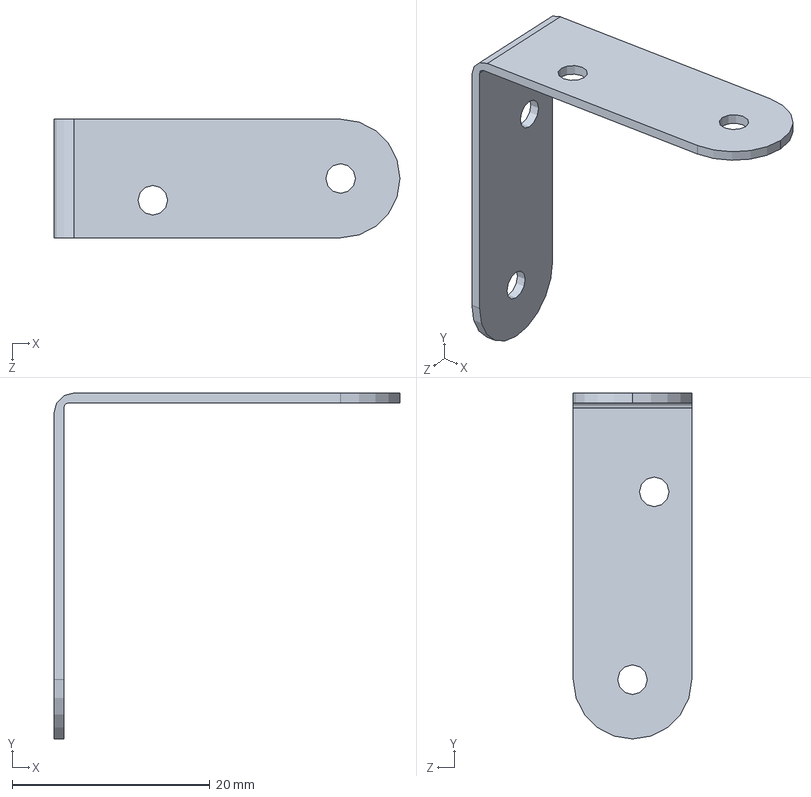
[picture p56: CAD file, 2021-06-19]
手柄模型/手柄机械零件/角码.SLDPRT
35.0 x 35.0 x 12.0 mm
