KaiyuanGONG/AI-Car/手柄模型/手柄电气零件/SwitchTwoFt.SLDPRT

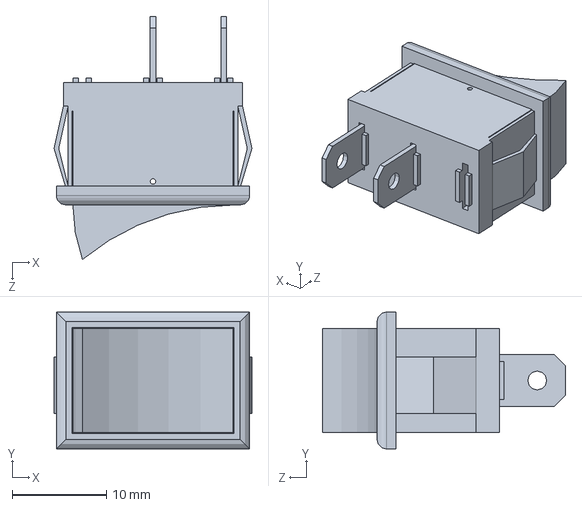
[picture p57: CAD file, 2021-06-19]
手柄模型/手柄电气零件/SwitchTwoFt.SLDPRT
21.0 x 14.5 x 25.8 mm
