KaiyuanGONG/AI-Car/机械图纸/外壳零件/前挡风玻璃.SLDPRT

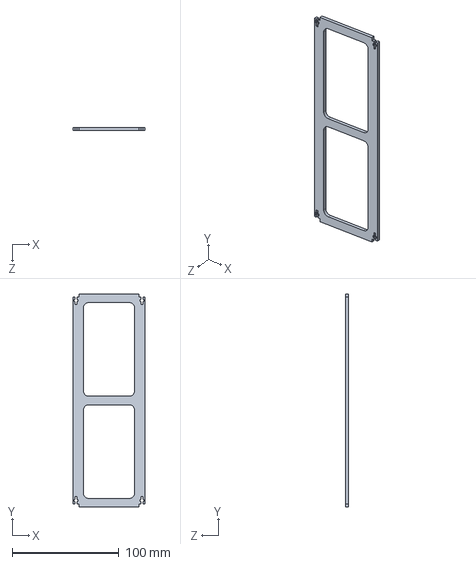
[picture p58: CAD file, 2021-06-19]
机械图纸/外壳零件/前挡风玻璃.SLDPRT
68.0 x 200.0 x 3.00 mm
