KaiyuanGONG/AI-Car/机械图纸/电气零件/2560.SLDPRT

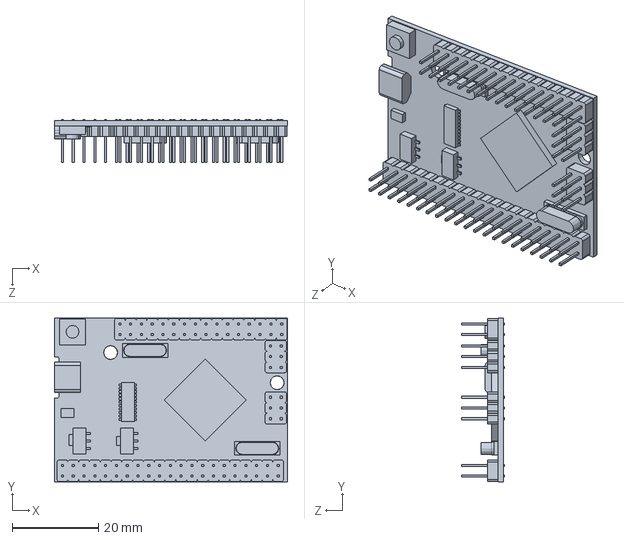
[picture p59: CAD file, 2021-06-19]
机械图纸/电气零件/2560.SLDPRT
54.0 x 38.0 x 10.0 mm
