KaiyuanGONG/AI-Car/机械图纸/轮组/奔驰标志.SLDPRT

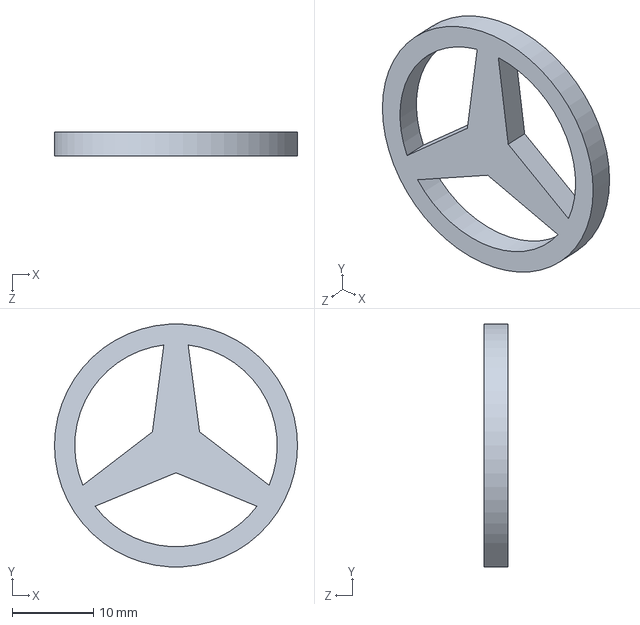
[picture p60: CAD file, 2021-06-19]
机械图纸/轮组/奔驰标志.SLDPRT
30.0 x 29.9 x 3.00 mm
