KaiyuanGONG/AI-Car/手柄模型/手柄机械零件/Board_Joy.SLDPRT

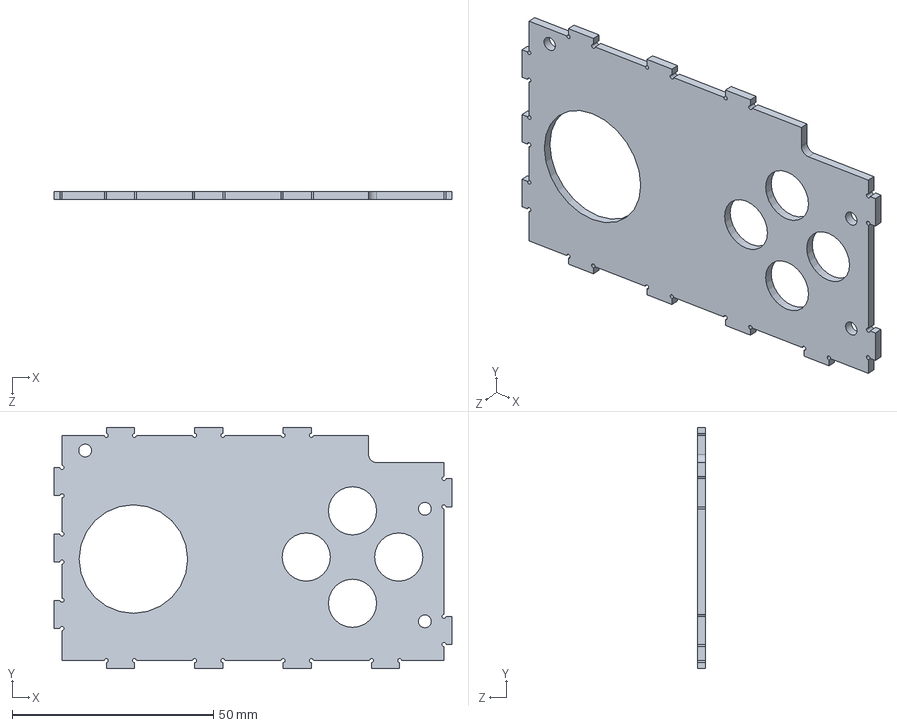
[picture p61: CAD file, 2021-06-19]
手柄模型/手柄机械零件/Board_Joy.SLDPRT
99.0 x 60.0 x 2.00 mm
