KaiyuanGONG/AI-Car/手柄模型/手柄电气零件/HC05BlousTooth.SLDPRT

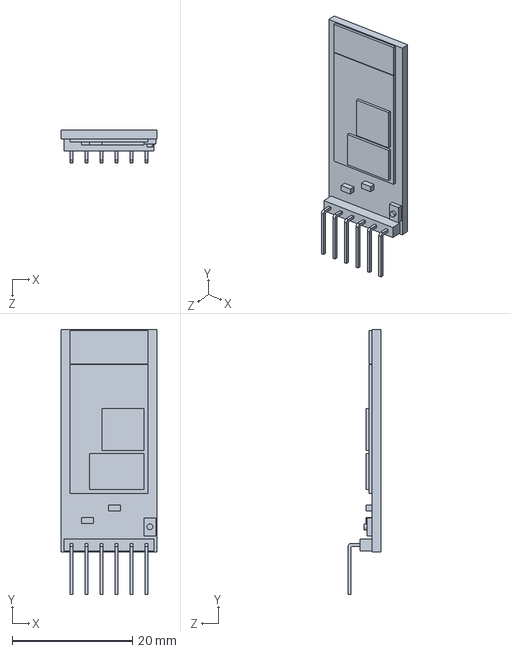
[picture p62: CAD file, 2021-06-19]
手柄模型/手柄电气零件/HC05BlousTooth.SLDPRT
16.0 x 44.0 x 5.50 mm
