KaiyuanGONG/AI-Car/机械图纸/外壳零件/车前架.SLDPRT

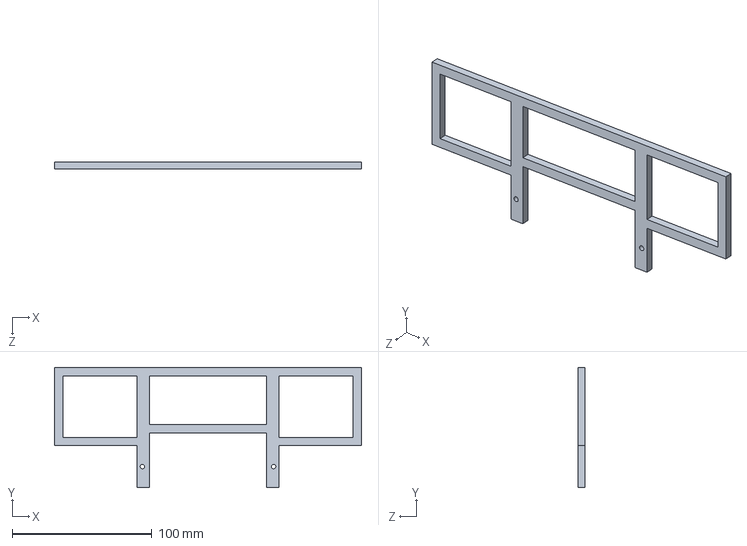
[picture p63: CAD file, 2021-06-19]
机械图纸/外壳零件/车前架.SLDPRT
220.0 x 86.0 x 5.00 mm
