KaiyuanGONG/AI-Car/机械图纸/电气零件/VoltageTest.SLDPRT

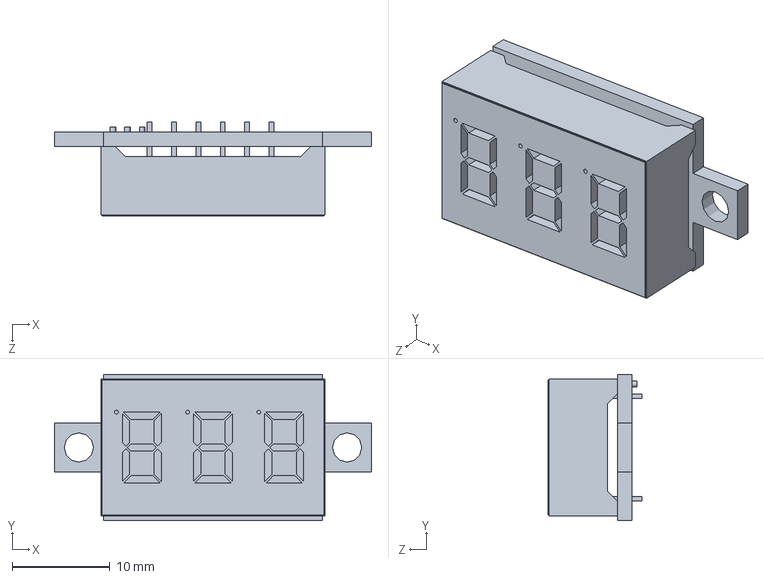
[picture p64: CAD file, 2021-06-19]
机械图纸/电气零件/VoltageTest.SLDPRT
32.5 x 15.0 x 9.60 mm
