KaiyuanGONG/AI-Car/机械图纸/轮组/BaseMotor.SLDPRT

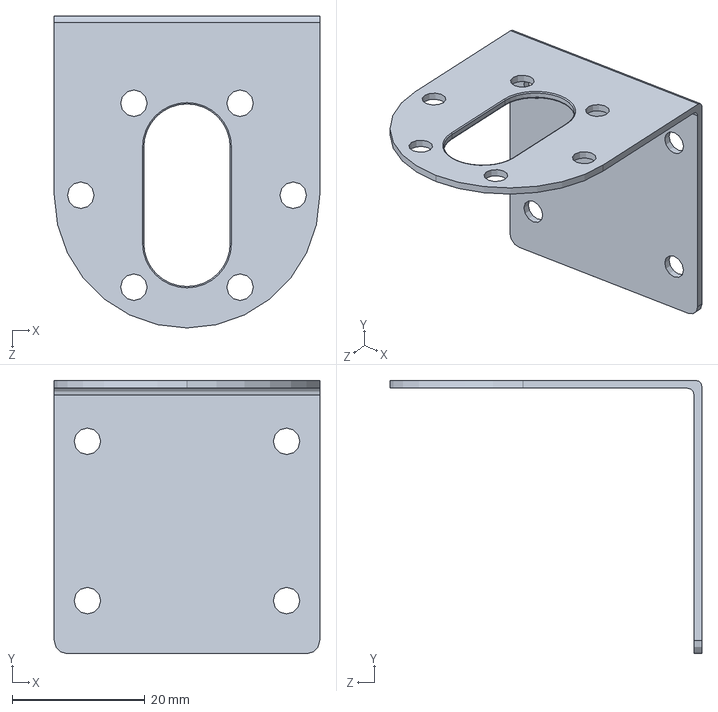
[picture p65: CAD file, 2021-06-19]
机械图纸/轮组/BaseMotor.SLDPRT
40.0 x 41.2 x 47.0 mm
