KaiyuanGONG/AI-Car/手柄模型/手柄机械零件/Board_Side2.SLDPRT

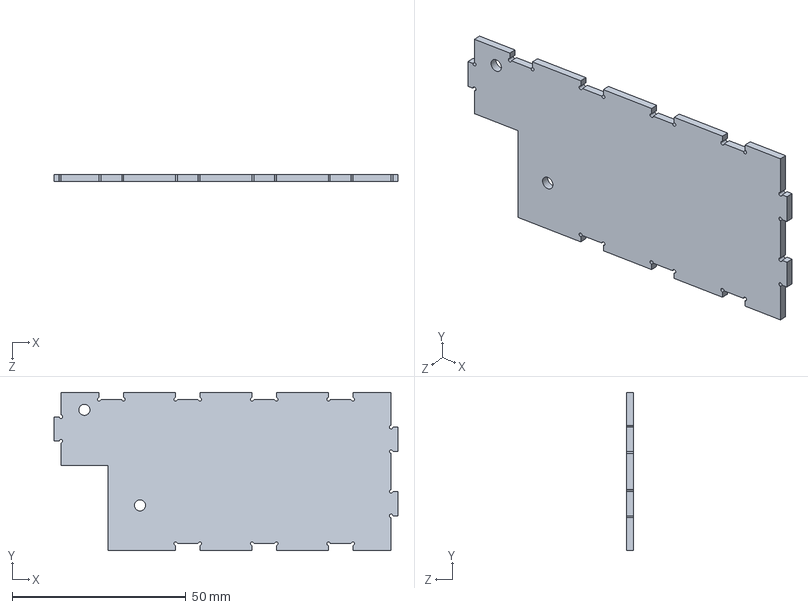
[picture p66: CAD file, 2021-06-19]
手柄模型/手柄机械零件/Board_Side2.SLDPRT
99.0 x 45.5 x 2.00 mm
