KaiyuanGONG/AI-Car/机械图纸/外壳零件/引擎盖.SLDPRT

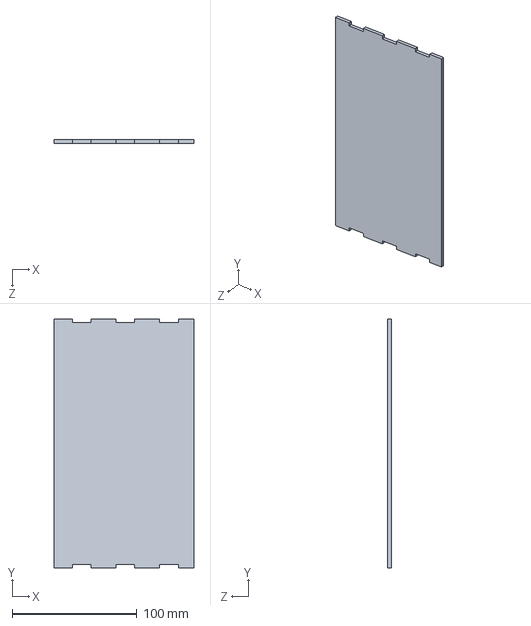
[picture p67: CAD file, 2021-06-19]
机械图纸/外壳零件/引擎盖.SLDPRT
112.2 x 200.0 x 3.00 mm
