KaiyuanGONG/AI-Car/机械图纸/电气零件/VoltageRegulatorSourse.SLDPRT

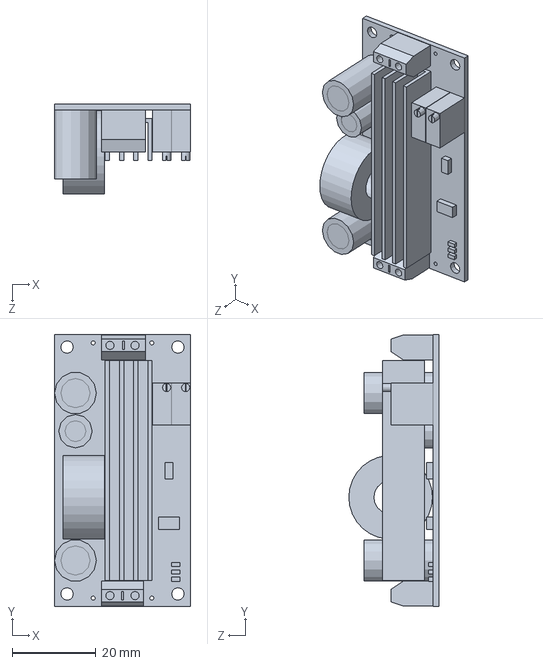
[picture p68: CAD file, 2021-06-19]
机械图纸/电气零件/VoltageRegulatorSourse.SLDPRT
32.5 x 65.0 x 21.6 mm
