KaiyuanGONG/AI-Car/机械图纸/轮组/Coupling.SLDPRT

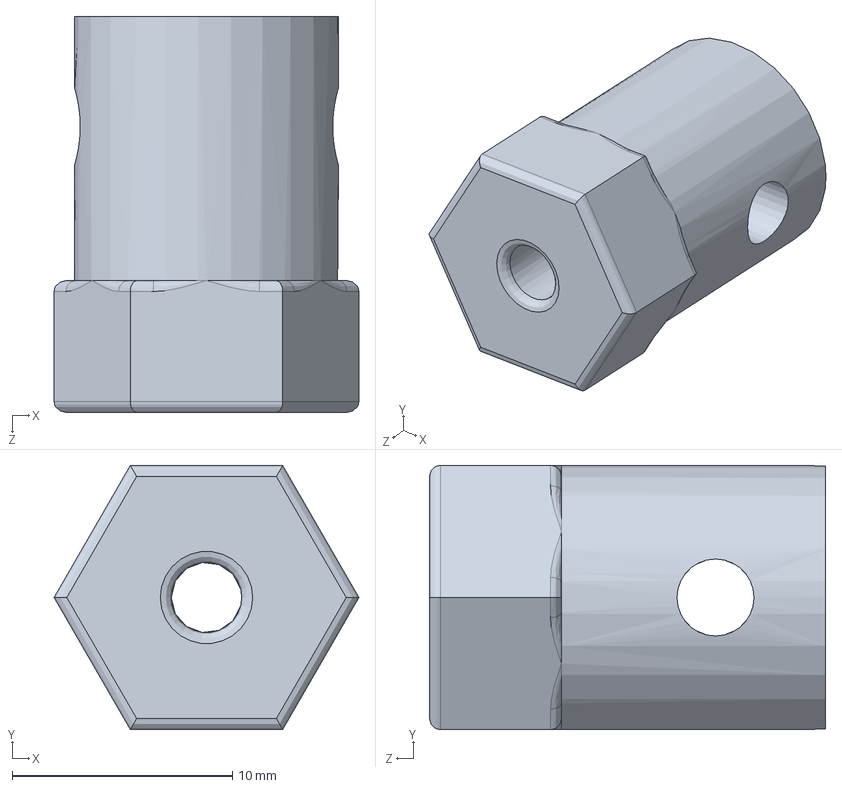
[picture p69: CAD file, 2021-06-19]
机械图纸/轮组/Coupling.SLDPRT
13.9 x 12.0 x 18.0 mm
