KaiyuanGONG/AI-Car/机械图纸/外壳零件/引擎盖翼.SLDPRT

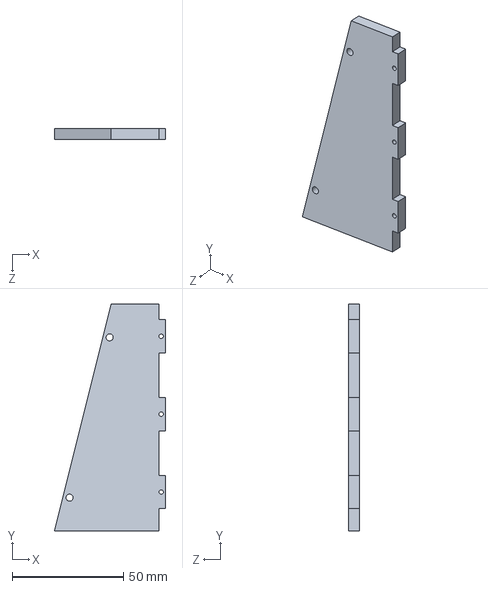
[picture p71: CAD file, 2021-06-19]
机械图纸/外壳零件/引擎盖翼.SLDPRT
50.0 x 102.0 x 5.00 mm
