KaiyuanGONG/AI-Car/机械图纸/电气零件/Battery.SLDPRT

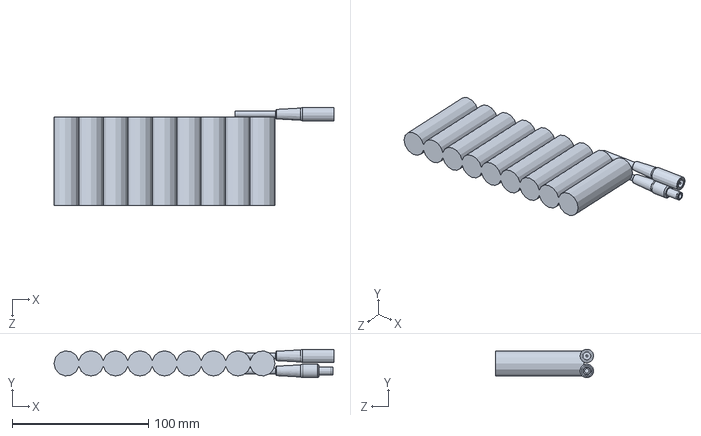
[picture p72: CAD file, 2021-06-19]
机械图纸/电气零件/Battery.SLDPRT
205.8 x 20.9 x 72.2 mm
