KaiyuanGONG/AI-Car/手柄模型/手柄机械零件/Board_Nano.SLDPRT

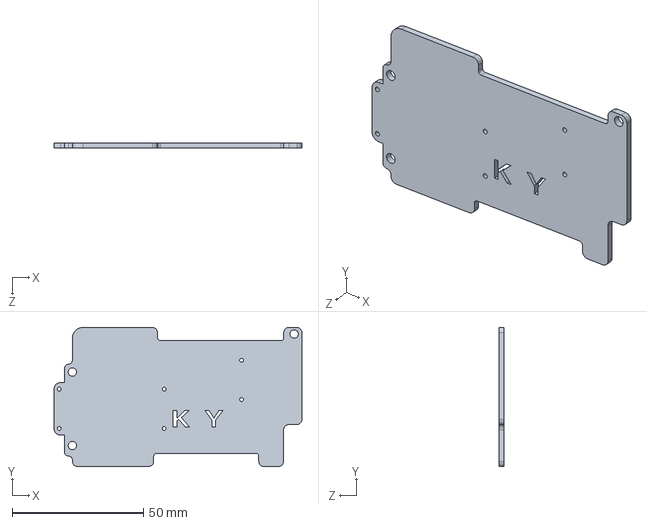
[picture p73: CAD file, 2021-06-19]
手柄模型/手柄机械零件/Board_Nano.SLDPRT
94.5 x 53.0 x 2.00 mm
