KaiyuanGONG/AI-Car/机械图纸/外壳零件/车侧板.SLDPRT

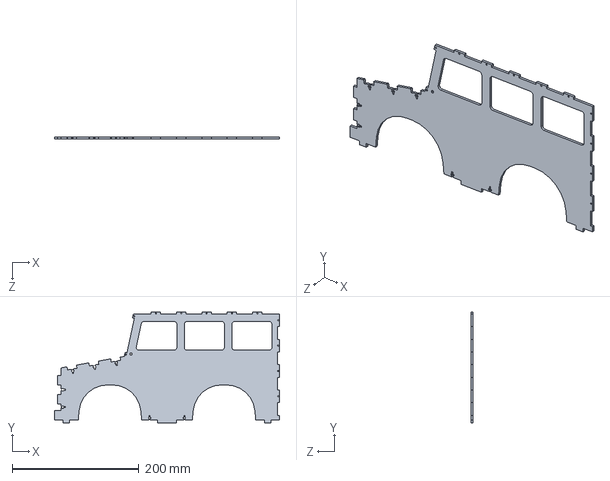
[picture p74: CAD file, 2021-06-19]
机械图纸/外壳零件/车侧板.SLDPRT
355.0 x 175.0 x 3.00 mm
