KaiyuanGONG/AI-Car/机械图纸/电气零件/40mm支撑铜柱.SLDPRT

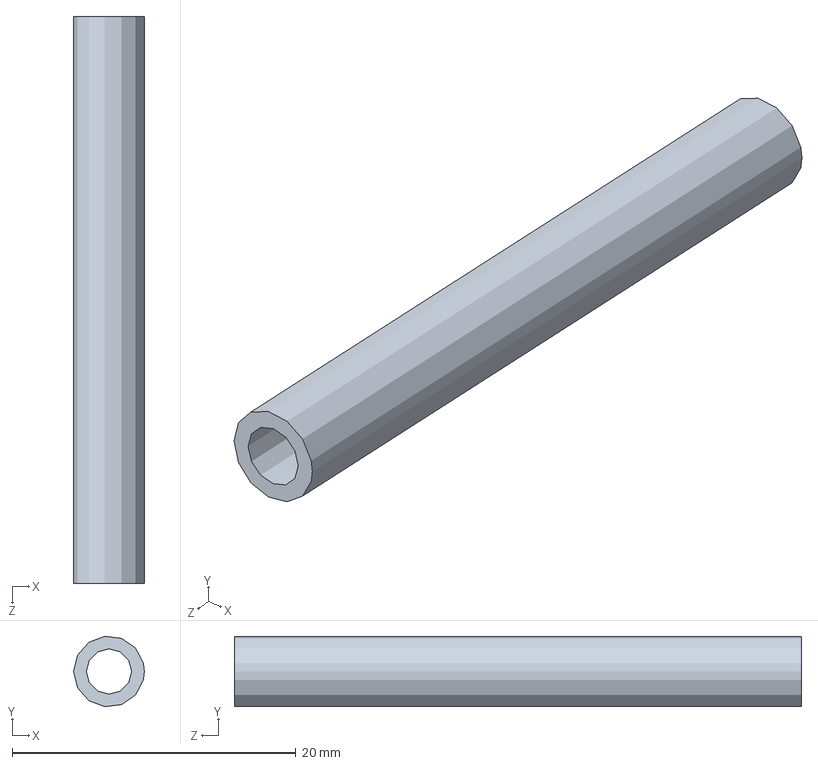
[picture p75: CAD file, 2021-06-19]
机械图纸/电气零件/40mm支撑铜柱.SLDPRT
5.00 x 4.96 x 40.0 mm
