KaiyuanGONG/AI-Car/手柄模型/手柄机械零件/Protect_Bat.SLDPRT

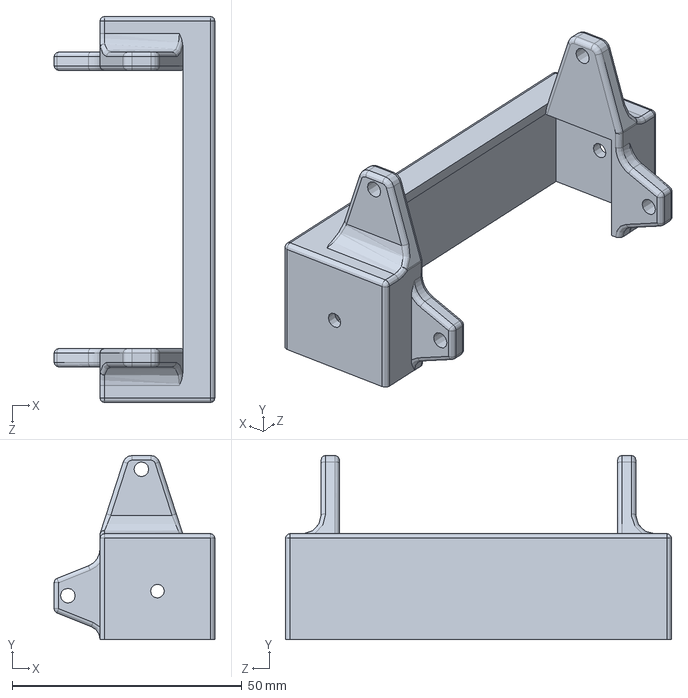
[picture p76: CAD file, 2021-06-19]
手柄模型/手柄机械零件/Protect_Bat.SLDPRT
35.0 x 40.0 x 84.0 mm
