KaiyuanGONG/AI-Car/机械图纸/外壳零件/侧边装饰.SLDPRT

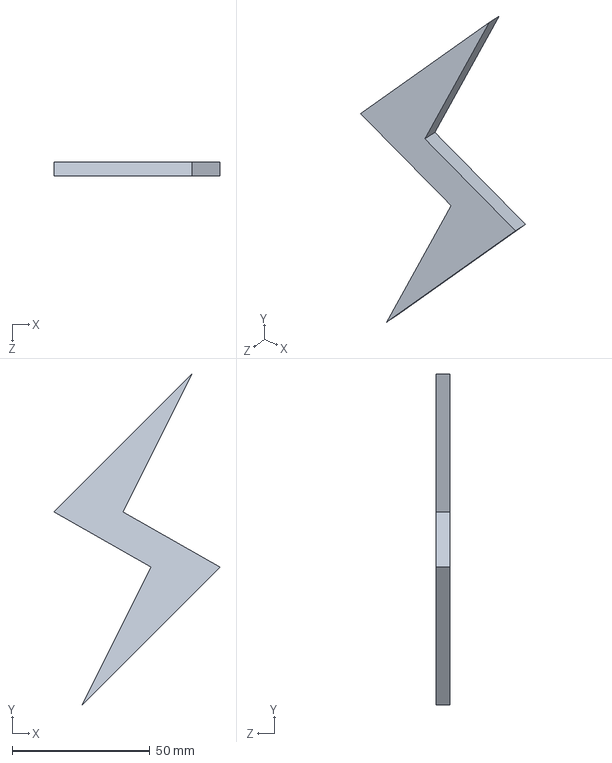
[picture p77: CAD file, 2021-06-19]
机械图纸/外壳零件/侧边装饰.SLDPRT
60.2 x 120.0 x 5.00 mm
