KaiyuanGONG/AI-Car/机械图纸/电气零件/Nano固定.SLDPRT

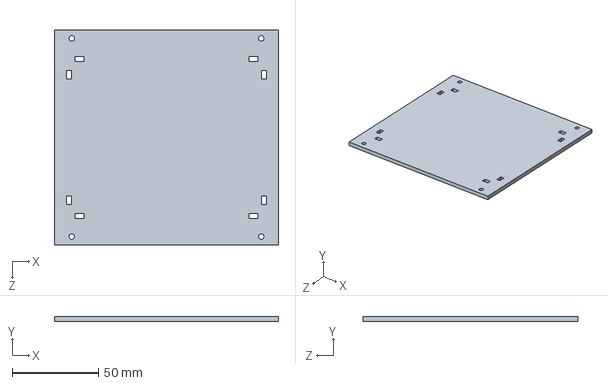
[picture p78: CAD file, 2021-06-19]
机械图纸/电气零件/Nano固定.SLDPRT
130.0 x 3.00 x 125.0 mm
