KaiyuanGONG/AI-Car/机械图纸/外壳零件/前保险杠.SLDPRT

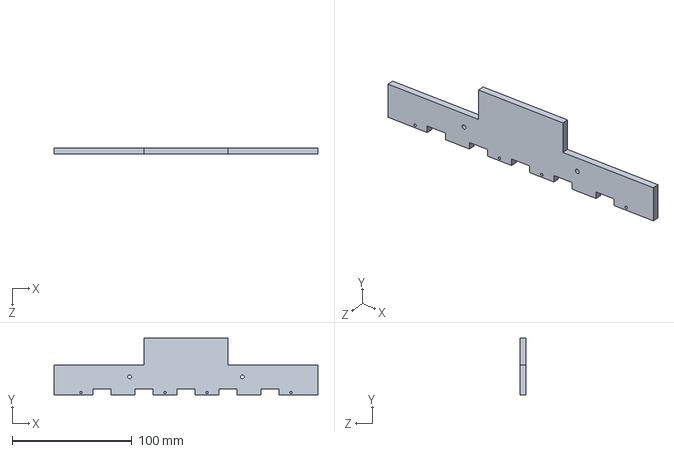
[picture p79: CAD file, 2021-06-19]
机械图纸/外壳零件/前保险杠.SLDPRT
220.0 x 47.3 x 5.00 mm
