KaiyuanGONG/AI-Car/机械图纸/电气零件/电池挡板.SLDPRT

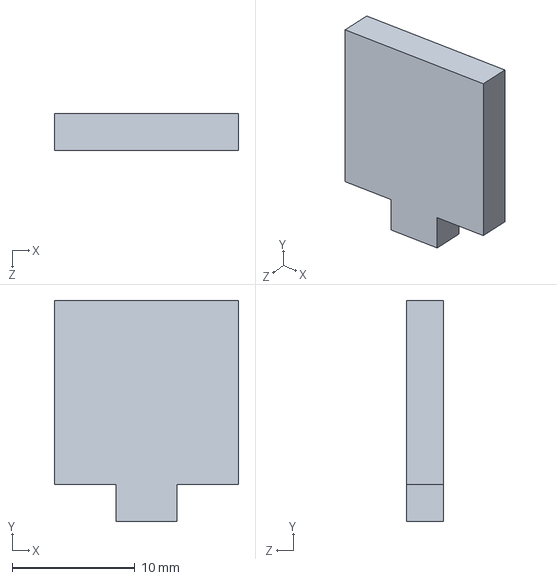
[picture p80: CAD file, 2021-06-19]
机械图纸/电气零件/电池挡板.SLDPRT
15.0 x 18.0 x 3.00 mm
