KaiyuanGONG/AI-Car/机械图纸/外壳零件/引擎盖中.SLDPRT

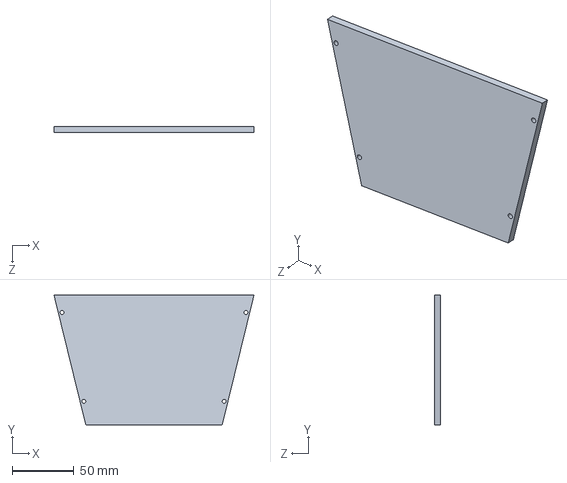
[picture p81: CAD file, 2021-06-19]
机械图纸/外壳零件/引擎盖中.SLDPRT
162.0 x 105.0 x 5.00 mm
