KaiyuanGONG/AI-Car/机械图纸/电气零件/JatsonNano.SLDPRT

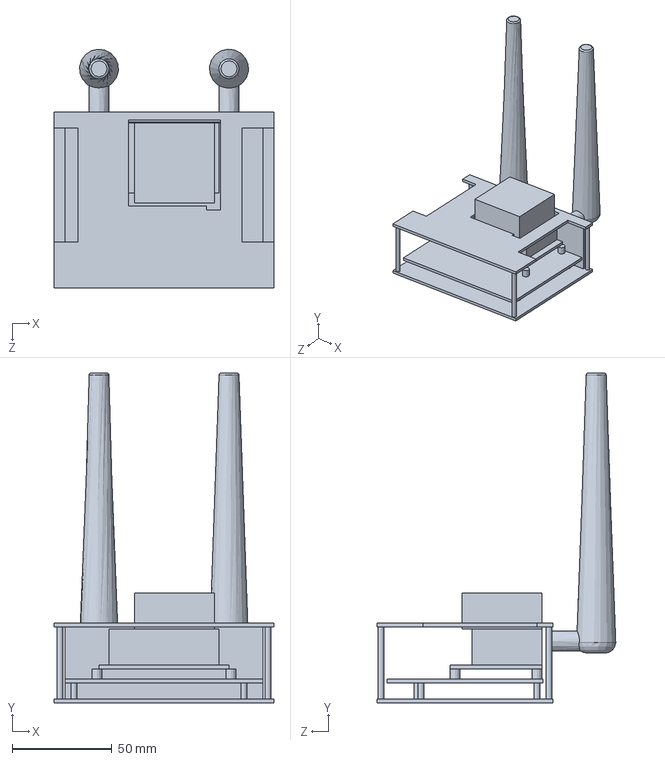
[picture p82: CAD file, 2021-06-19]
机械图纸/电气零件/JatsonNano.SLDPRT
110.0 x 165.0 x 119.3 mm
