KaiyuanGONG/AI-Car/机械图纸/外壳零件/后视镜.SLDPRT

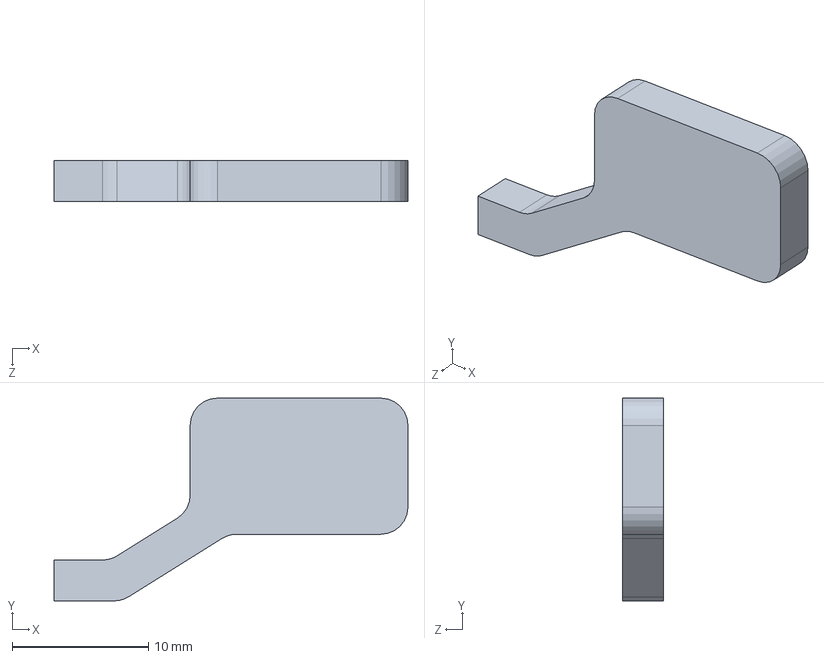
[picture p83: CAD file, 2021-06-19]
机械图纸/外壳零件/后视镜.SLDPRT
26.0 x 14.9 x 3.00 mm
