KaiyuanGONG/AI-Car/机械图纸/电气零件/board_2560.SLDPRT

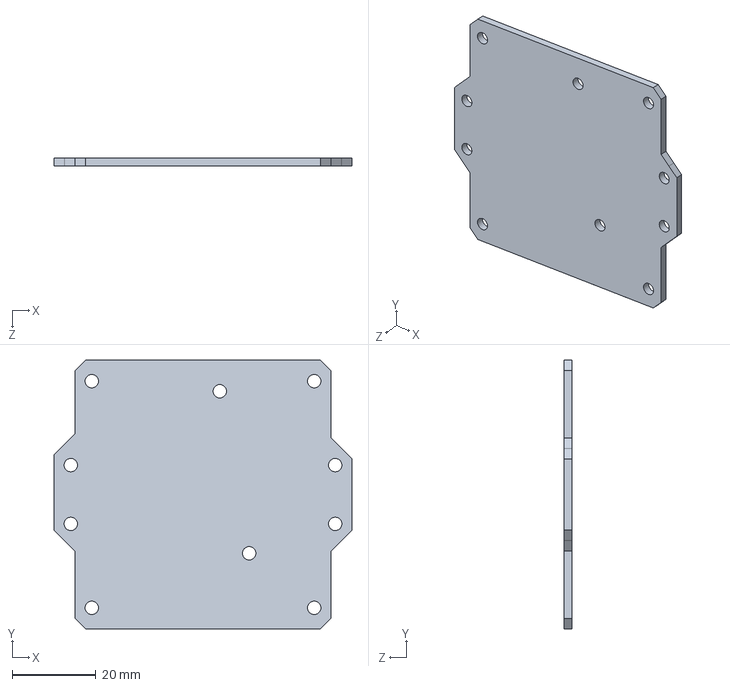
[picture p84: CAD file, 2021-06-19]
机械图纸/电气零件/board_2560.SLDPRT
71.0 x 64.0 x 2.00 mm
