KaiyuanGONG/AI-Car/机械图纸/外壳零件/车顶板.SLDPRT

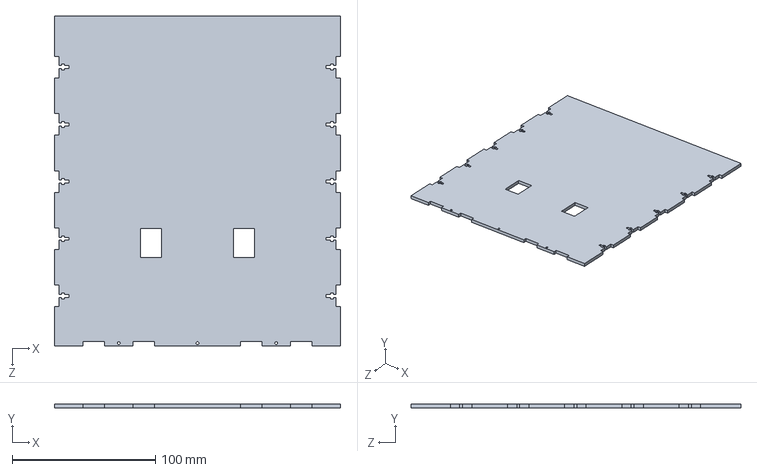
[picture p85: CAD file, 2021-06-19]
机械图纸/外壳零件/车顶板.SLDPRT
200.0 x 3.00 x 230.8 mm
