KaiyuanGONG/AI-Car/机械图纸/电气零件/电池固定板.SLDPRT

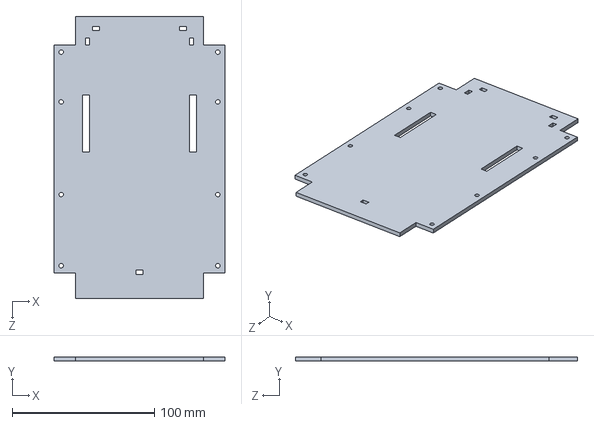
[picture p86: CAD file, 2021-06-19]
机械图纸/电气零件/电池固定板.SLDPRT
120.0 x 3.00 x 198.0 mm
