KaiyuanGONG/AI-Car/机械图纸/外壳零件/车前网.SLDPRT

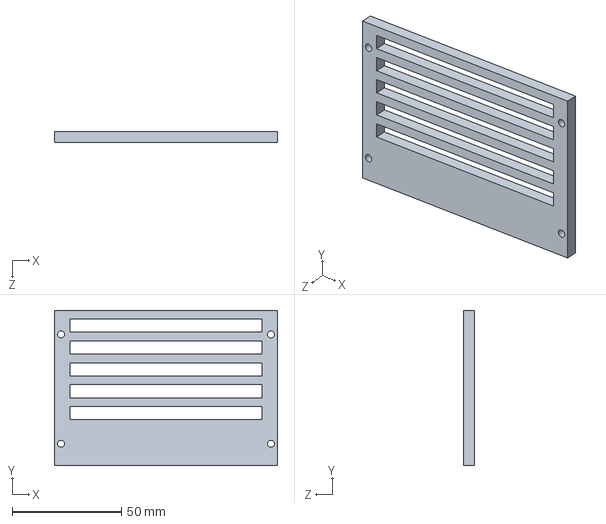
[picture p87: CAD file, 2021-06-19]
机械图纸/外壳零件/车前网.SLDPRT
102.0 x 71.0 x 5.00 mm
