KaiyuanGONG/AI-Car/机械图纸/电气零件/ConnectorMale.SLDPRT

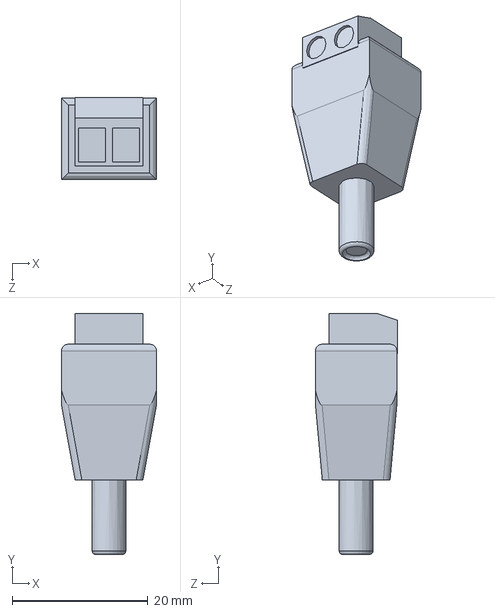
[picture p88: CAD file, 2021-06-19]
机械图纸/电气零件/ConnectorMale.SLDPRT
14.0 x 35.5 x 12.1 mm
