KaiyuanGONG/AI-Car/机械图纸/外壳零件/车后板.SLDPRT

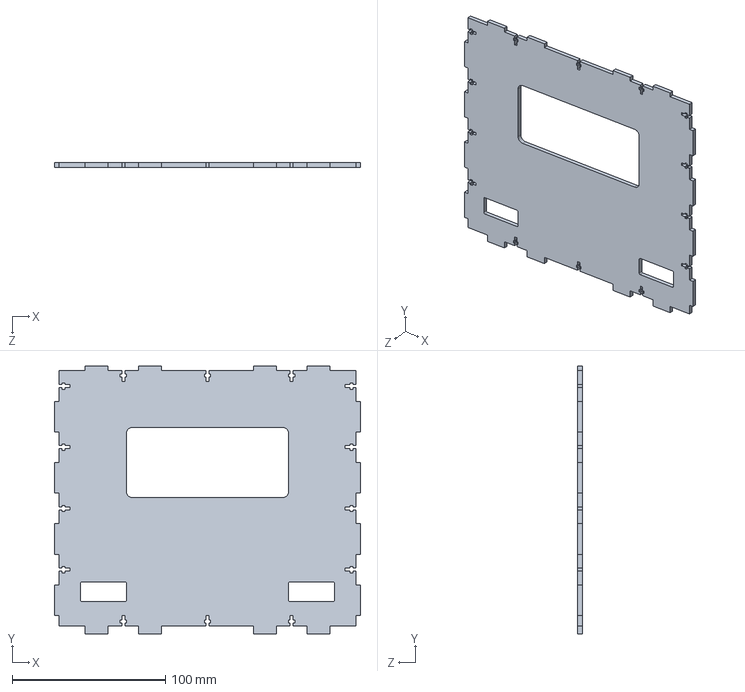
[picture p89: CAD file, 2021-06-19]
机械图纸/外壳零件/车后板.SLDPRT
200.0 x 175.0 x 3.00 mm
