KaiyuanGONG/AI-Car/(list of files, cad)

Other CAD files:
机械图纸/轮组/高轮组.SLDASM
机械图纸/亚克力加工/3mm/电池固定板.DWG
机械图纸/亚克力加工/5mm/前保险杠.DWG
机械图纸/亚克力加工/3mm/前挡风玻璃.DWG
机械图纸/亚克力加工/5mm/电池挡板16件.DWG
机械图纸/亚克力加工/3mm/车侧板2件.DWG
机械图纸/亚克力加工/5mm/底盘.DWG
机械图纸/亚克力加工/3mm/车顶板.DWG
机械图纸/亚克力加工/5mm/轮胎装饰9件.DWG
机械图纸/亚克力加工/3mm/车后板.DWG
机械图纸/亚克力加工/5mm/车前网.DWG
机械图纸/亚克力加工/3mm/侧边装饰3件.DWG
机械图纸/亚克力加工/5mm/引擎盖中.DWG
机械图纸/亚克力加工/3mm/Nano固定.DWG
机械图纸/亚克力加工/5mm/车前架.DWG
机械图纸/亚克力加工/5mm/奔驰标志.DWG
机械图纸/亚克力加工/5mm/引擎盖翼2件.DWG
机械图纸/亚克力加工/5mm/车大灯2件.DWG
机械图纸/亚克力加工/5mm/后视镜2件.DWG
机械图纸/亚克力加工/5mm/轮组固定板4件.DWG
手柄模型/手柄装配体/手柄装配体.SLDPRT
手柄模型/手柄装配体/手柄装配体.STL
