KaiyuanGONG/AI-Car/其他资料/JoyShield资料/Schematic==0G-00004701==JoystickShield.pdf

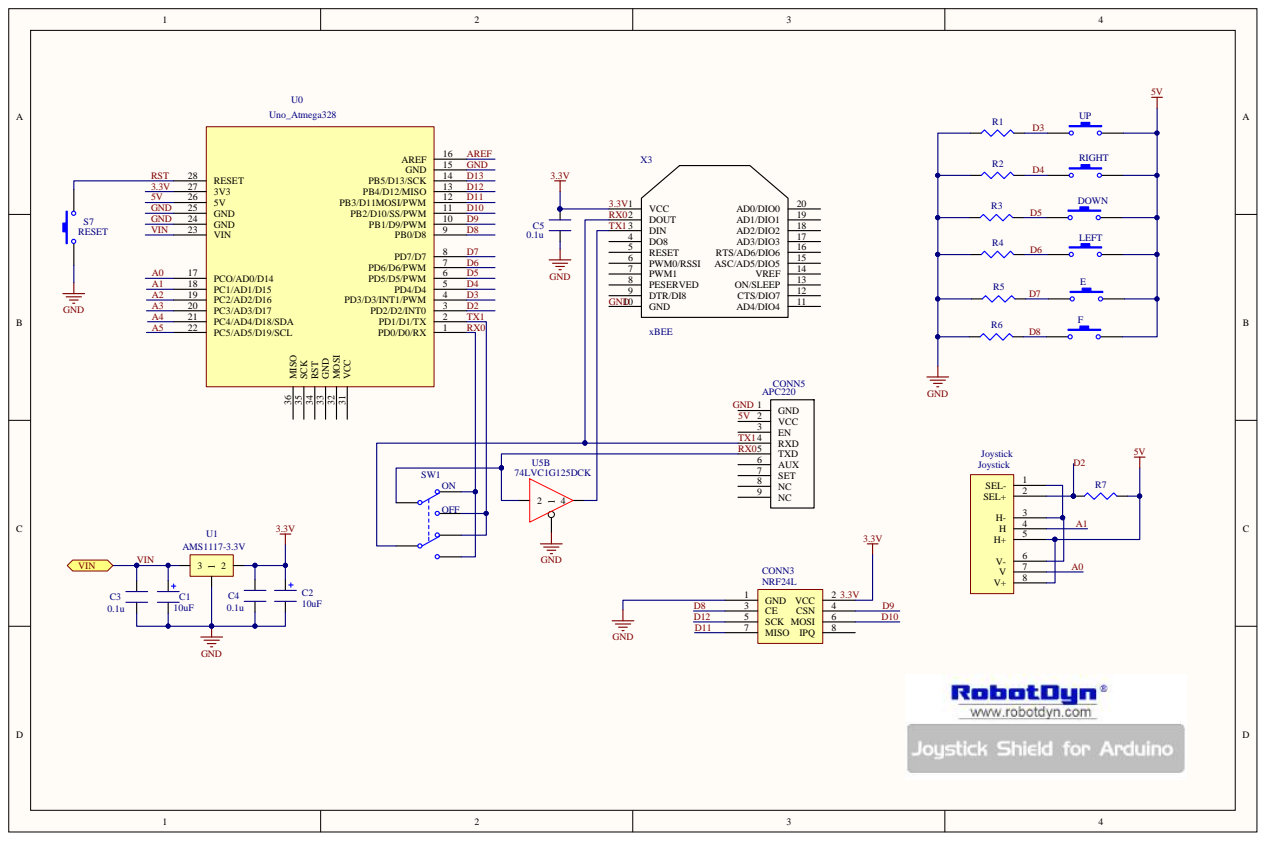
[picture p90: page 1]
